simplementeUnPorito/vertical-helicopter-control/docs/img/matlab-gui.png

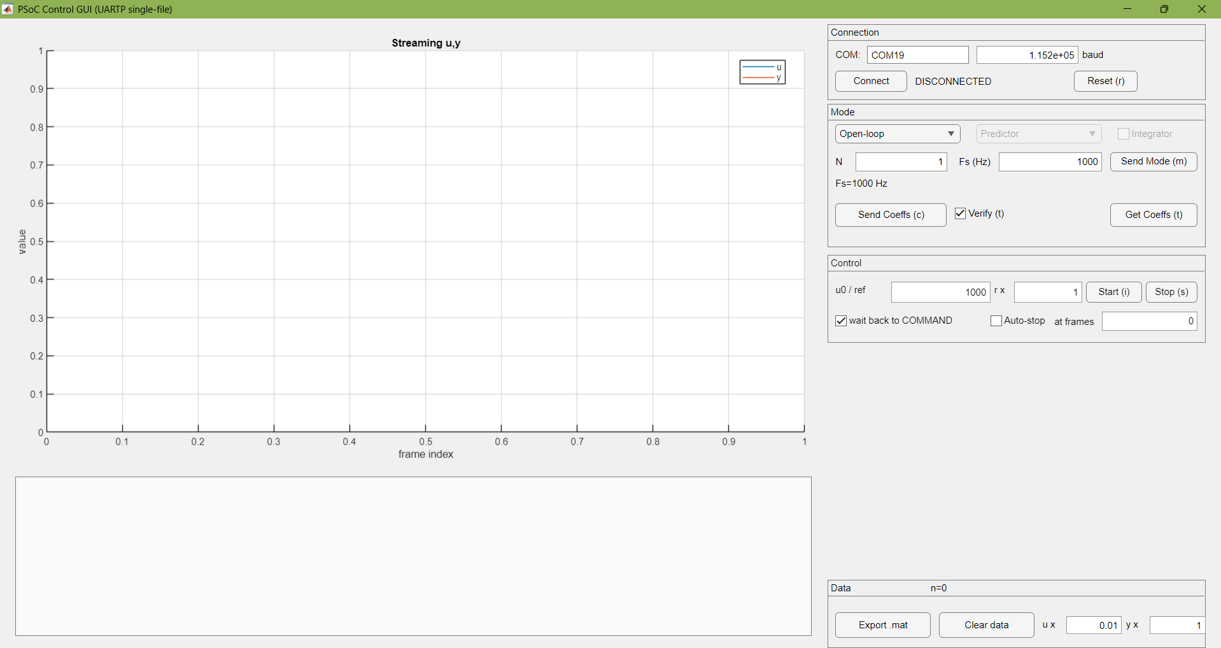
docs/img/matlab-gui.png
