simplementeUnPorito/vertical-helicopter-control/docs/report-src/img/bode/bode_C.png

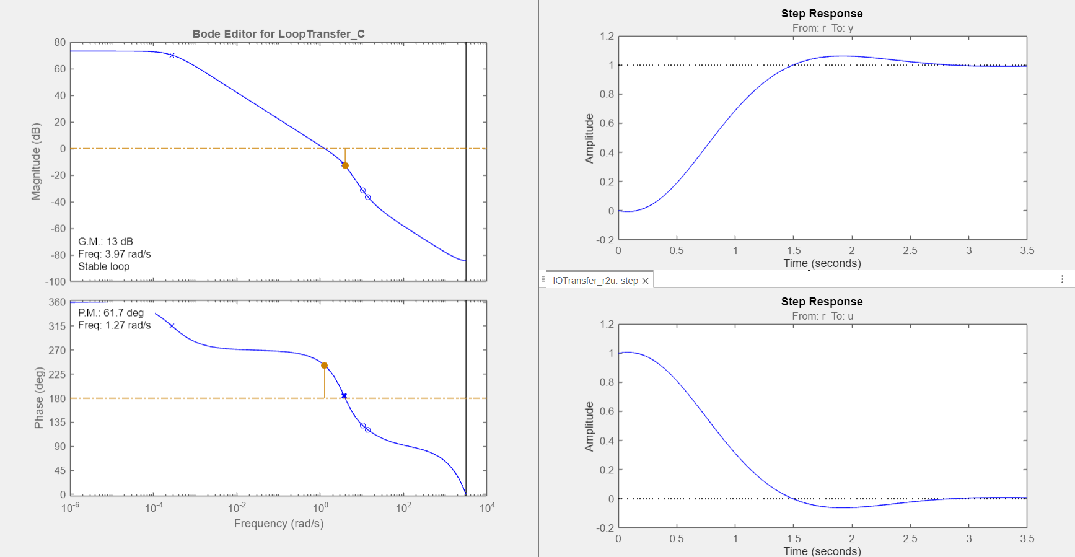
docs/report-src/img/bode/bode_C.png
