simplementeUnPorito/vertical-helicopter-control/docs/report-src/img/bode/bode_compensado.png

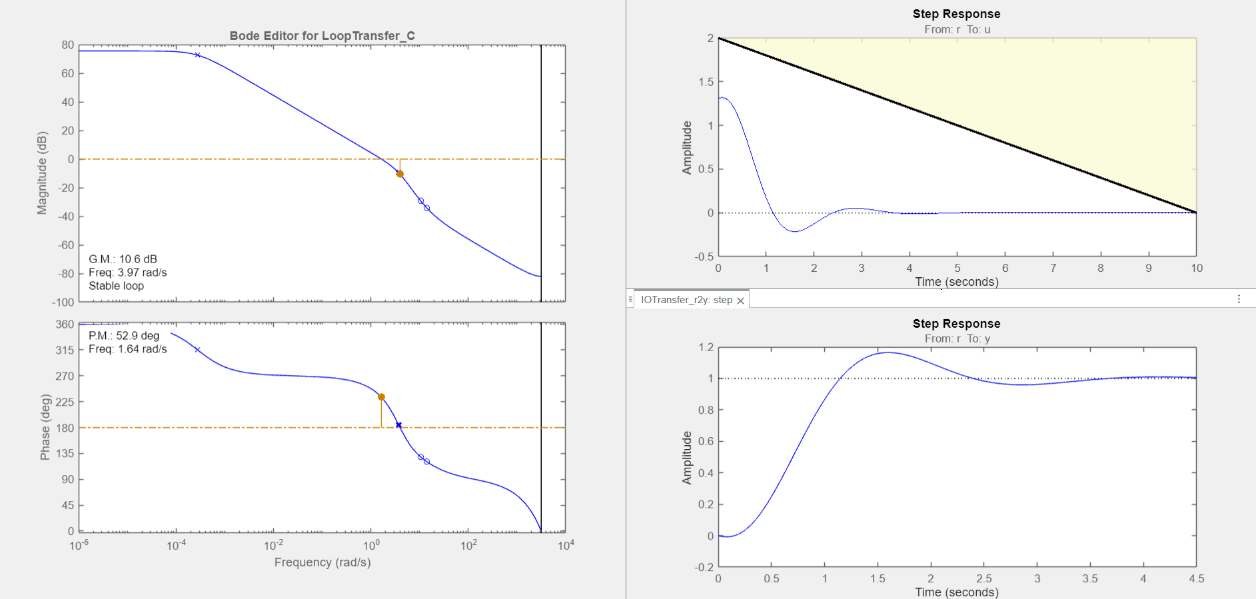
docs/report-src/img/bode/bode_compensado.png
