simplementeUnPorito/vertical-helicopter-control/docs/report-src/img/bode/bode_practica.png

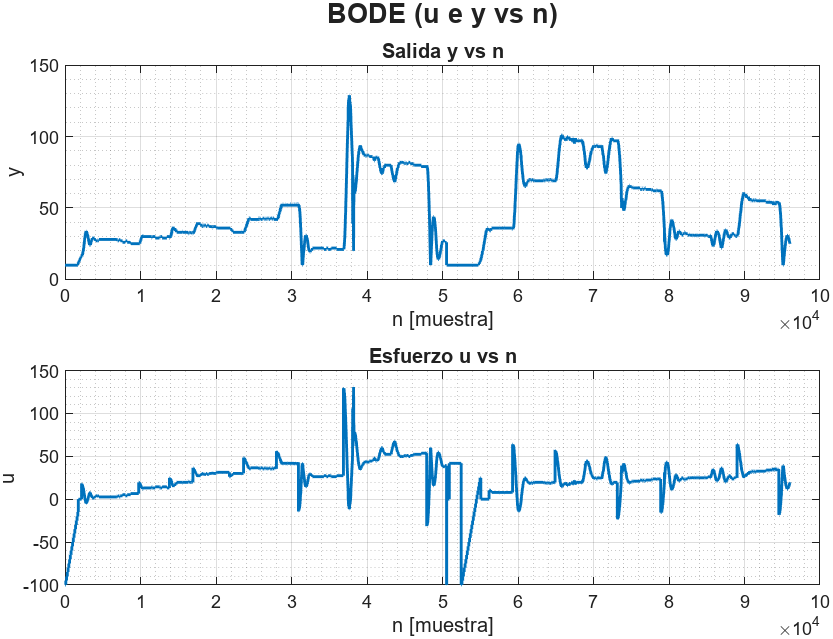
docs/report-src/img/bode/bode_practica.png
