simplementeUnPorito/vertical-helicopter-control/docs/report-src/img/bode/bodeMat.png

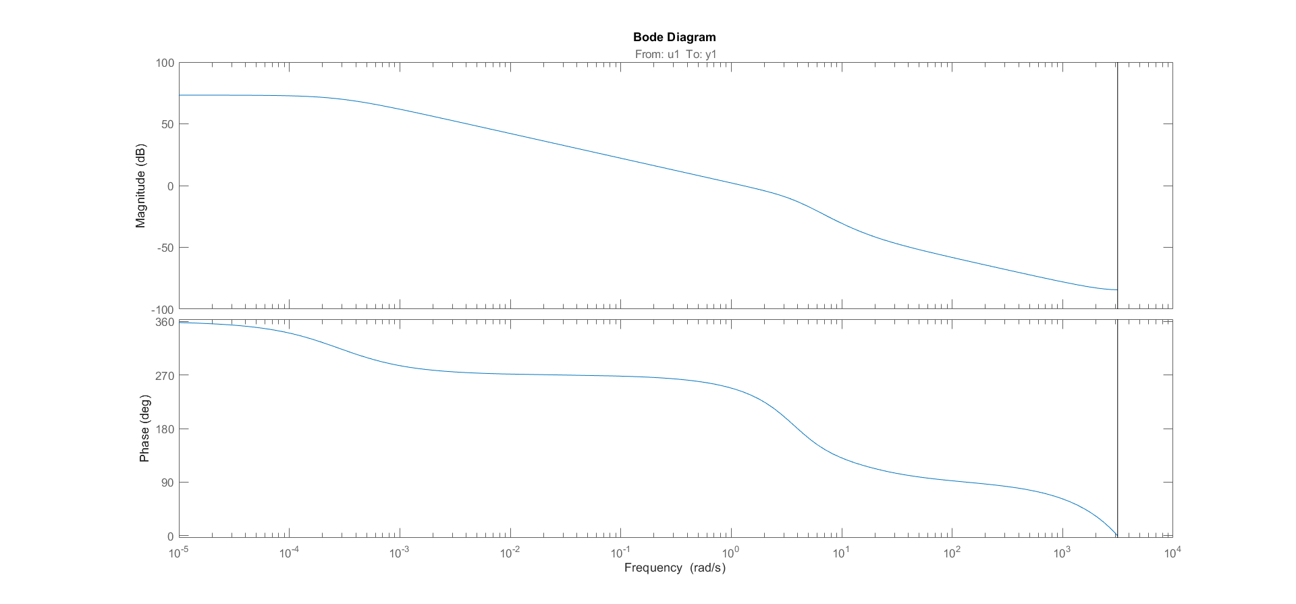
docs/report-src/img/bode/bodeMat.png
