simplementeUnPorito/vertical-helicopter-control/docs/report-src/img/CircUnitarioPlanta.png

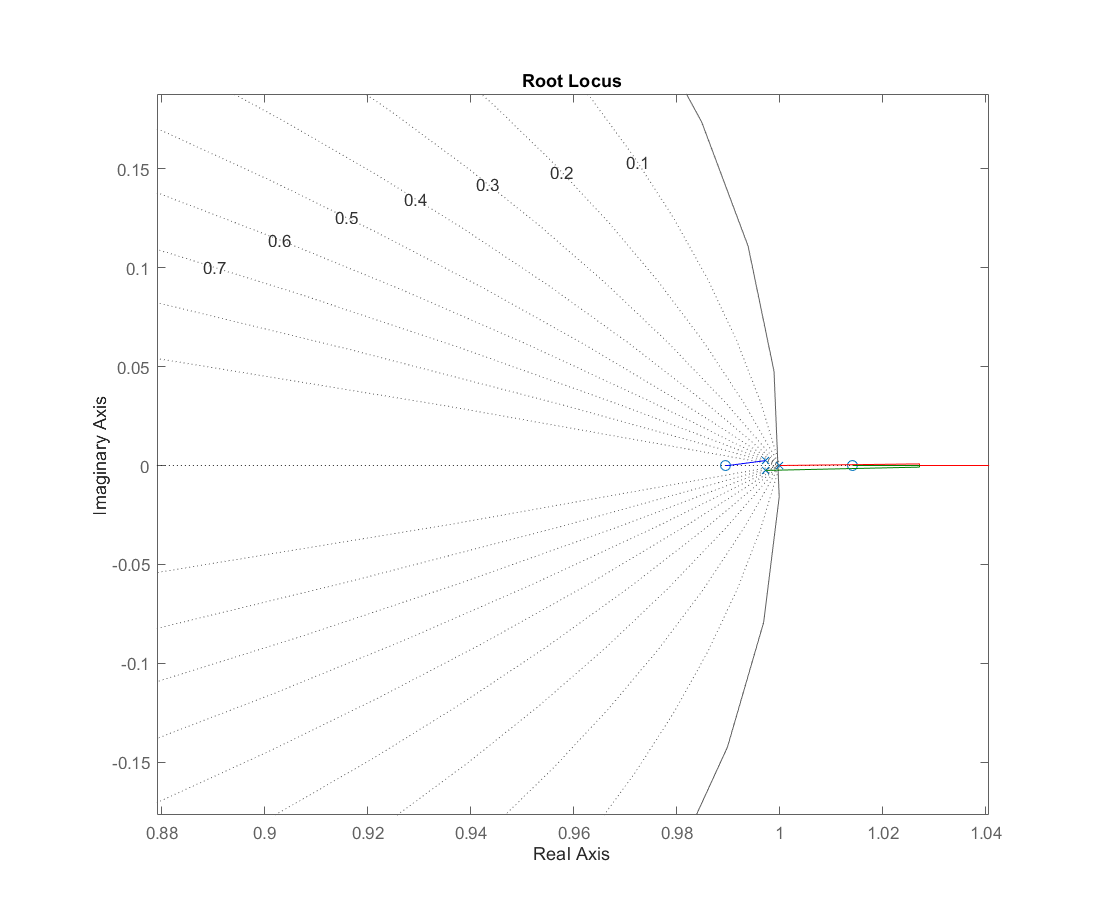
docs/report-src/img/CircUnitarioPlanta.png
