simplementeUnPorito/vertical-helicopter-control/docs/report-src/img/Disenos/abrazadera.png

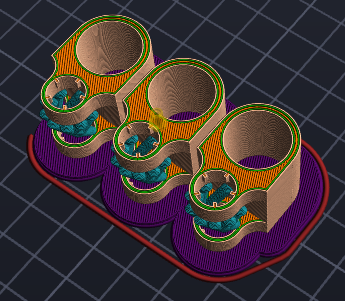
docs/report-src/img/Disenos/abrazadera.png
