simplementeUnPorito/vertical-helicopter-control/docs/report-src/img/Disenos/brazo2.png

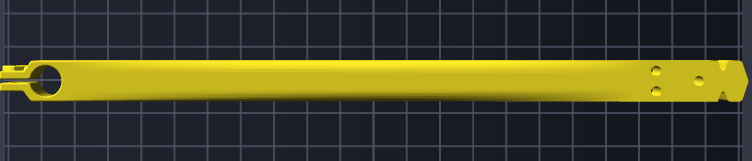
docs/report-src/img/Disenos/brazo2.png
