simplementeUnPorito/vertical-helicopter-control/docs/report-src/img/Disenos/brazo.png

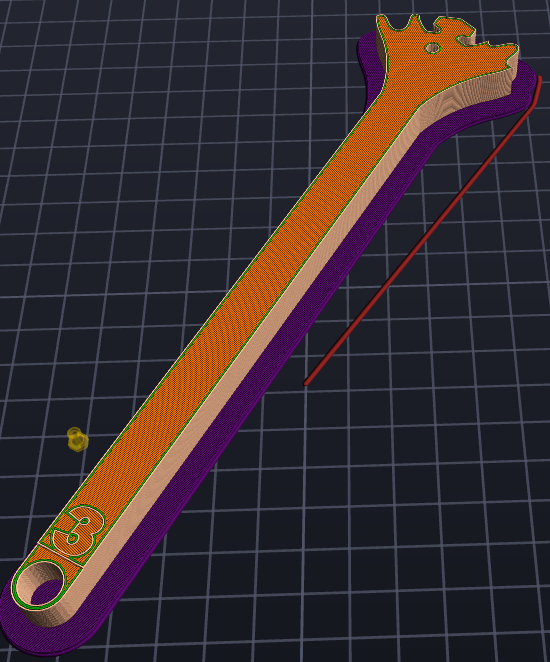
docs/report-src/img/Disenos/brazo.png
