simplementeUnPorito/vertical-helicopter-control/docs/report-src/img/Disenos/cuerpo1.png

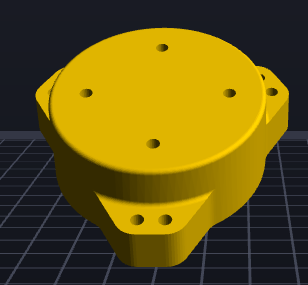
docs/report-src/img/Disenos/cuerpo1.png
