simplementeUnPorito/vertical-helicopter-control/docs/report-src/img/Disenos/cuerpo3.jpeg

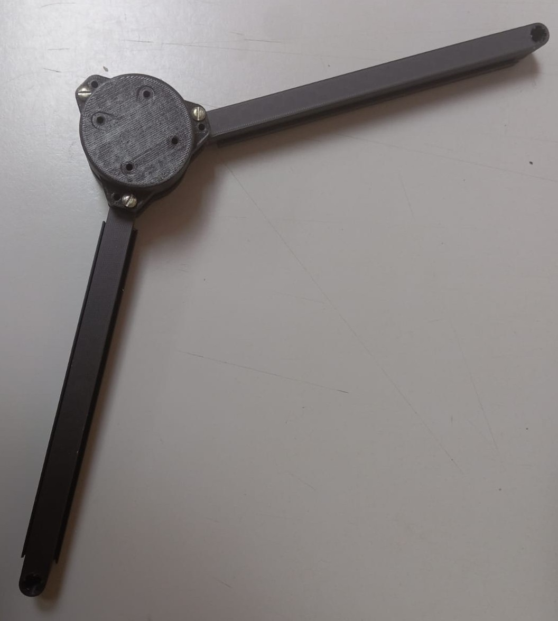
docs/report-src/img/Disenos/cuerpo3.jpeg
