simplementeUnPorito/vertical-helicopter-control/docs/report-src/img/Disenos/cuerpo-soporte3.jpeg

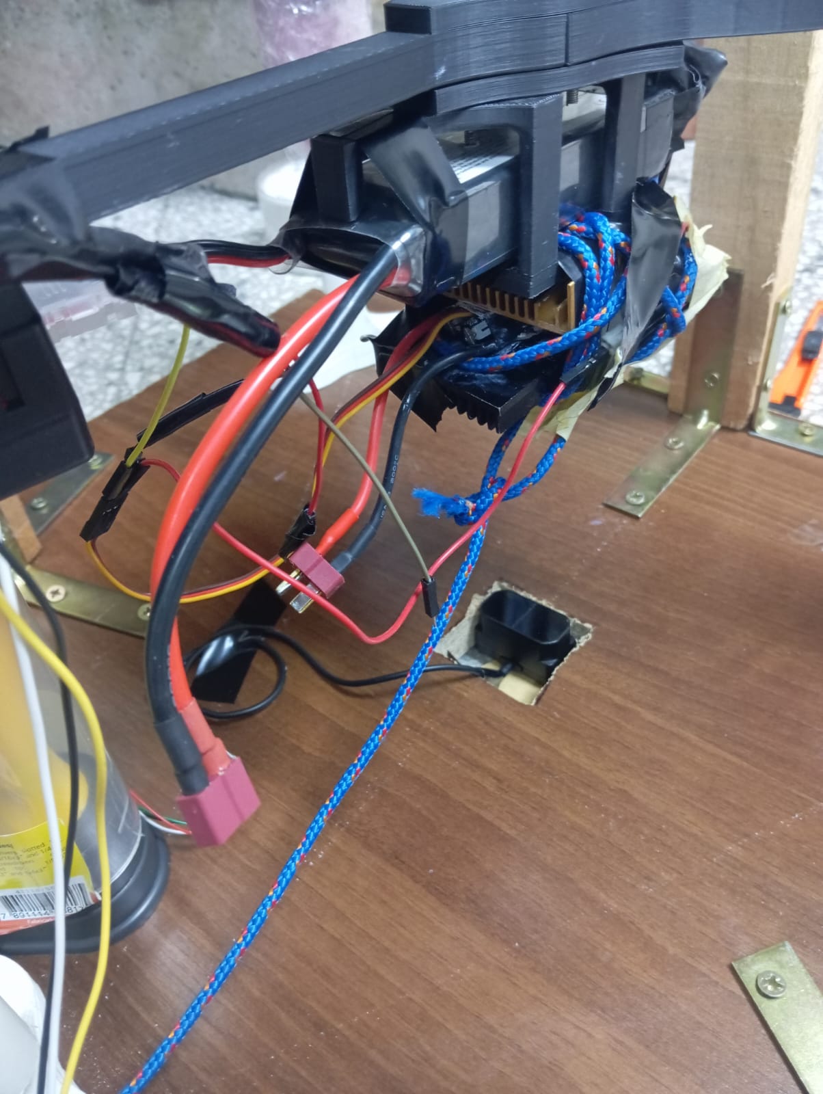
docs/report-src/img/Disenos/cuerpo-soporte3.jpeg
