simplementeUnPorito/vertical-helicopter-control/docs/report-src/img/Disenos/soporte-bateria.jpeg

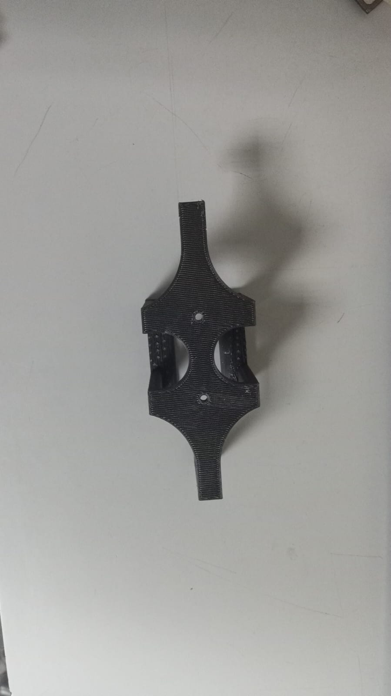
docs/report-src/img/Disenos/soporte-bateria.jpeg
