simplementeUnPorito/vertical-helicopter-control/docs/report-src/img/Disenos/soporte-cuerpo.png

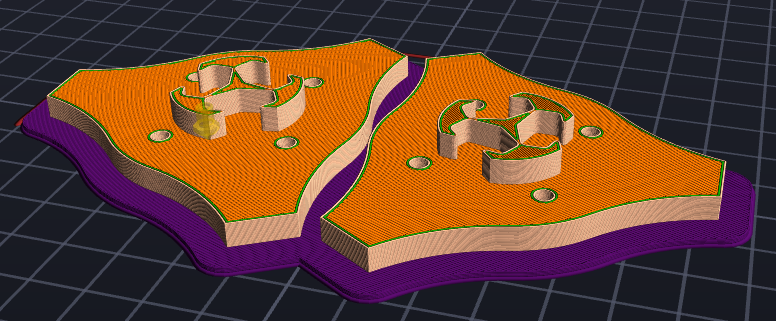
docs/report-src/img/Disenos/soporte-cuerpo.png
