simplementeUnPorito/vertical-helicopter-control/docs/report-src/img/Disenos/soporte_base.png

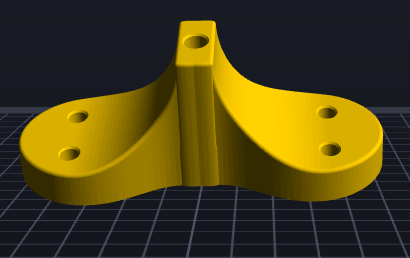
docs/report-src/img/Disenos/soporte_base.png
