simplementeUnPorito/vertical-helicopter-control/docs/report-src/img/Disenos/soporte_techo.png

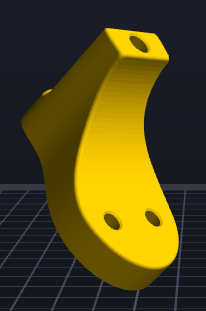
docs/report-src/img/Disenos/soporte_techo.png
