simplementeUnPorito/vertical-helicopter-control/docs/report-src/img/ima/bodePID.png

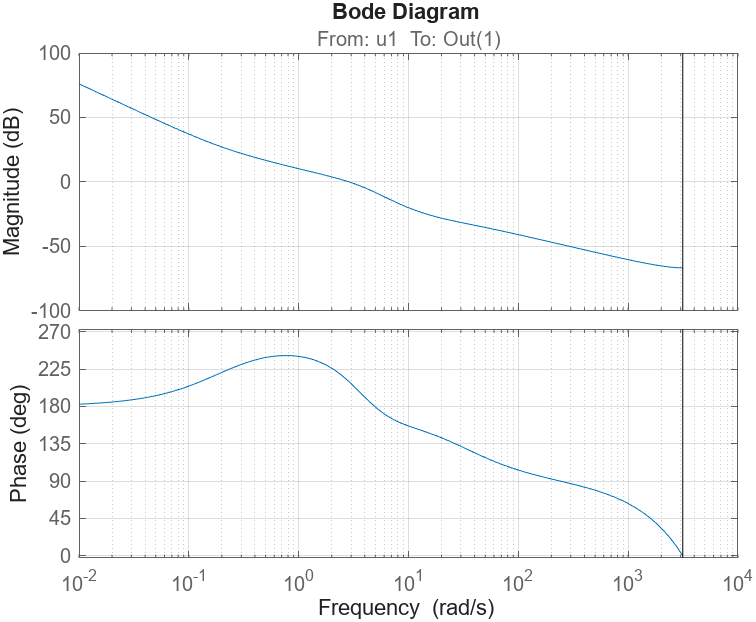
docs/report-src/img/ima/bodePID.png
