simplementeUnPorito/vertical-helicopter-control/docs/report-src/img/ima/circuloUnitarioPID.png

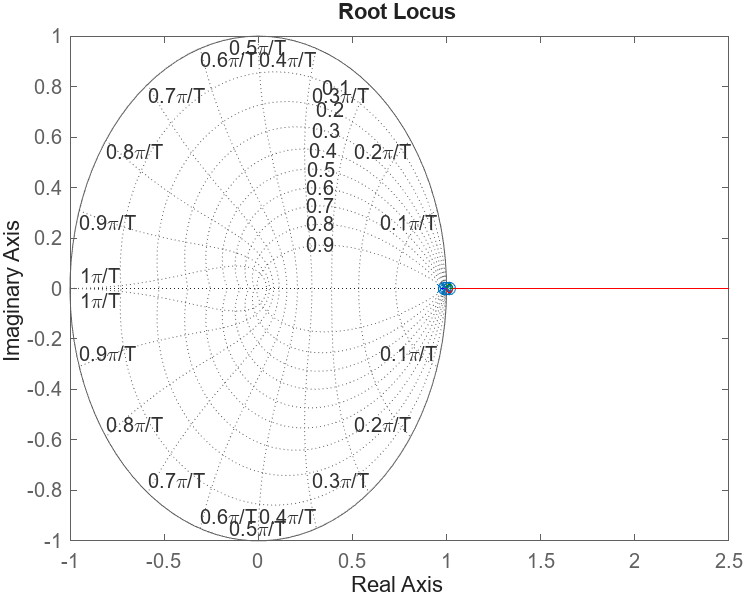
docs/report-src/img/ima/circuloUnitarioPID.png
