simplementeUnPorito/vertical-helicopter-control/docs/report-src/img/ima/rstaPID.png

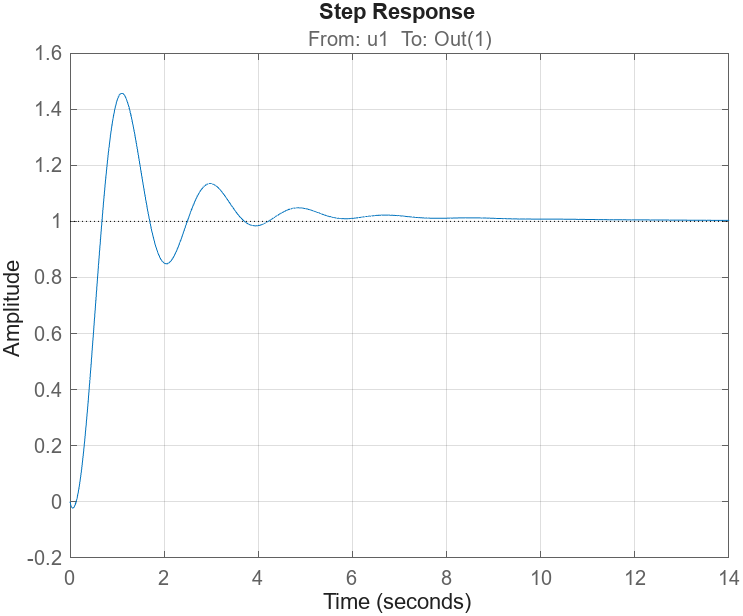
docs/report-src/img/ima/rstaPID.png
