simplementeUnPorito/vertical-helicopter-control/docs/report-src/img/LQGi/LQGi_esfuerzo_ruido.png

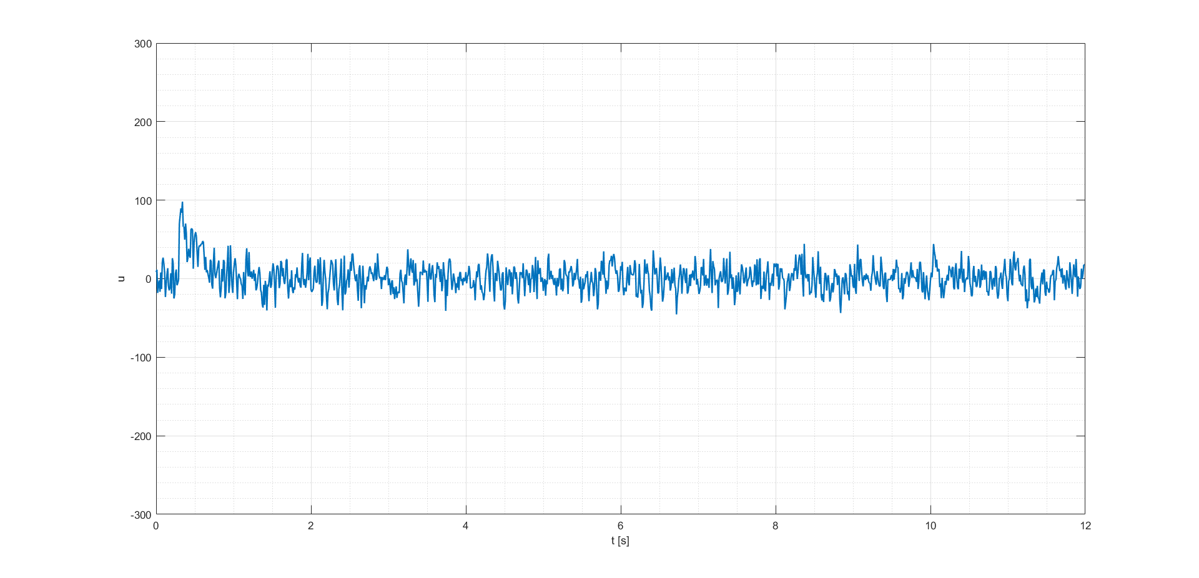
docs/report-src/img/LQGi/LQGi_esfuerzo_ruido.png
