simplementeUnPorito/vertical-helicopter-control/docs/report-src/img/LQGi/LQGi_pzmap_NaranajaOBS_AzulPLANTA.png

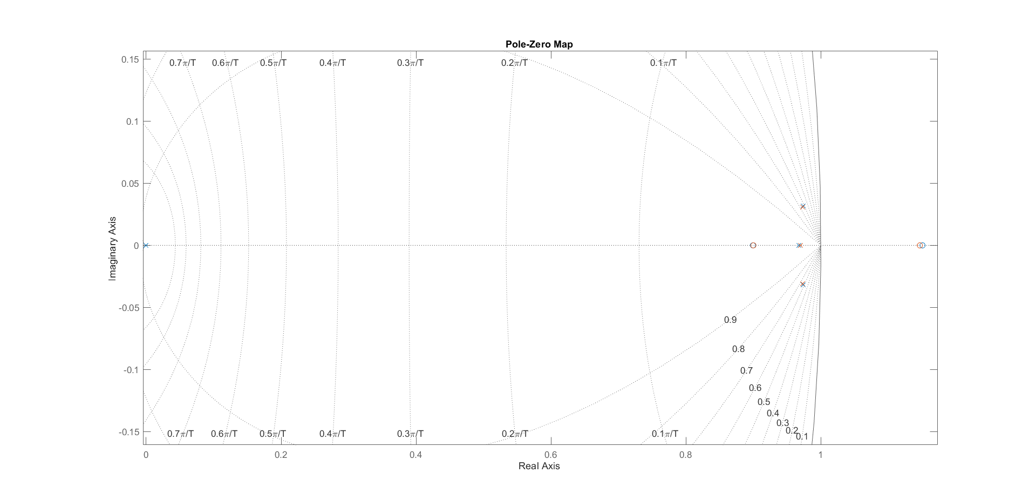
docs/report-src/img/LQGi/LQGi_pzmap_NaranajaOBS_AzulPLANTA.png
