simplementeUnPorito/vertical-helicopter-control/docs/report-src/img/LQR/LQR_esfuerzo.png

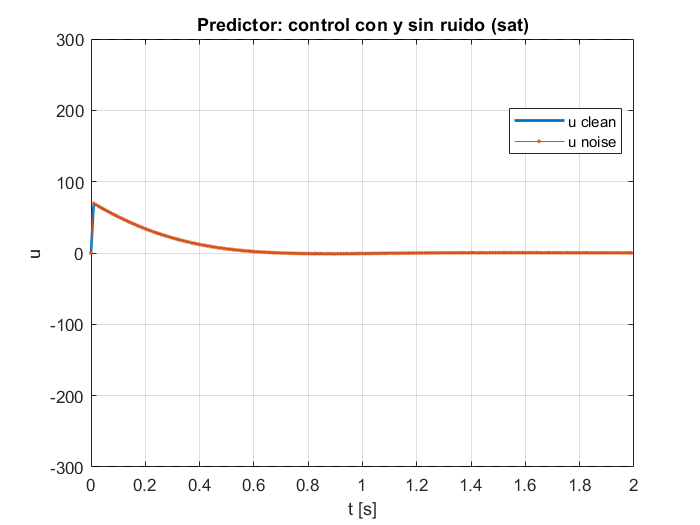
docs/report-src/img/LQR/LQR_esfuerzo.png
