simplementeUnPorito/vertical-helicopter-control/docs/report-src/img/LQR/LQR_pred_practico.png

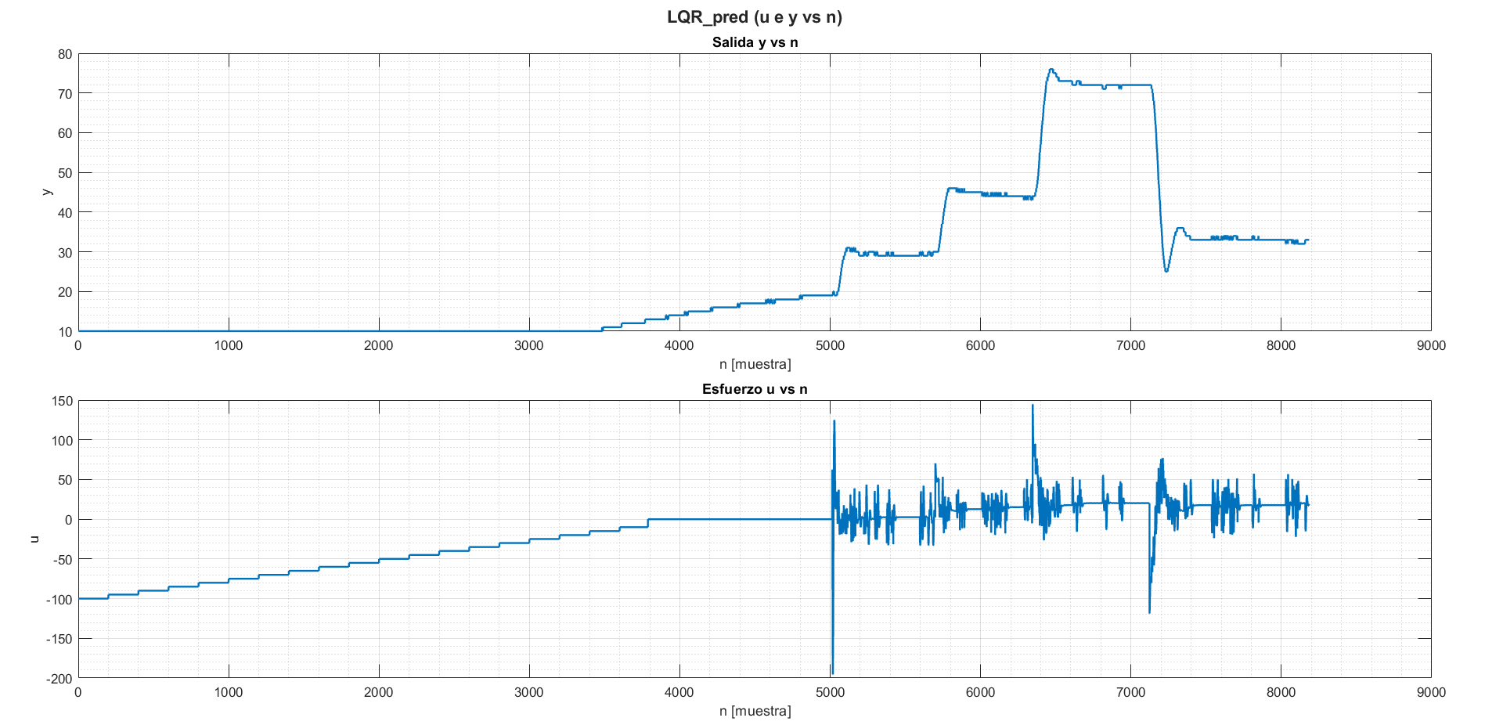
docs/report-src/img/LQR/LQR_pred_practico.png
