simplementeUnPorito/vertical-helicopter-control/docs/report-src/img/PID/Astrom.png

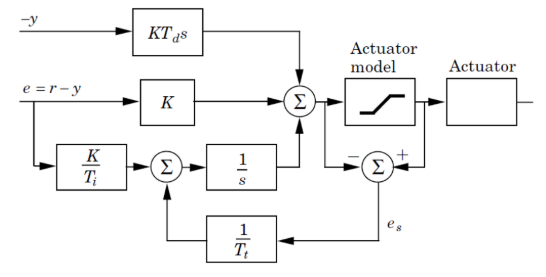
docs/report-src/img/PID/Astrom.png
