simplementeUnPorito/vertical-helicopter-control/docs/report-src/img/PID/astrom_diagrama.png

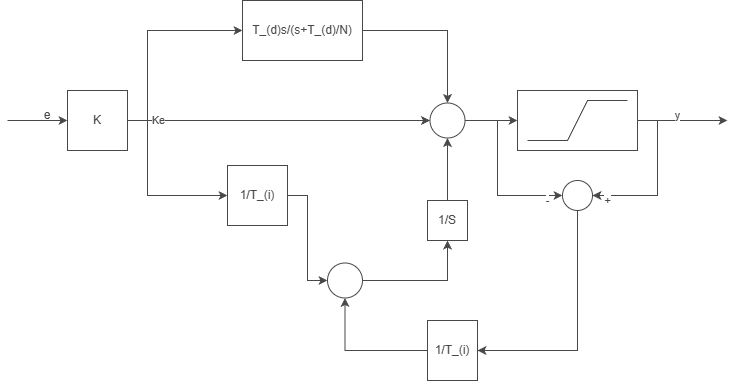
docs/report-src/img/PID/astrom_diagrama.png
