simplementeUnPorito/vertical-helicopter-control/docs/report-src/img/PID/EsfuerzoPID.png

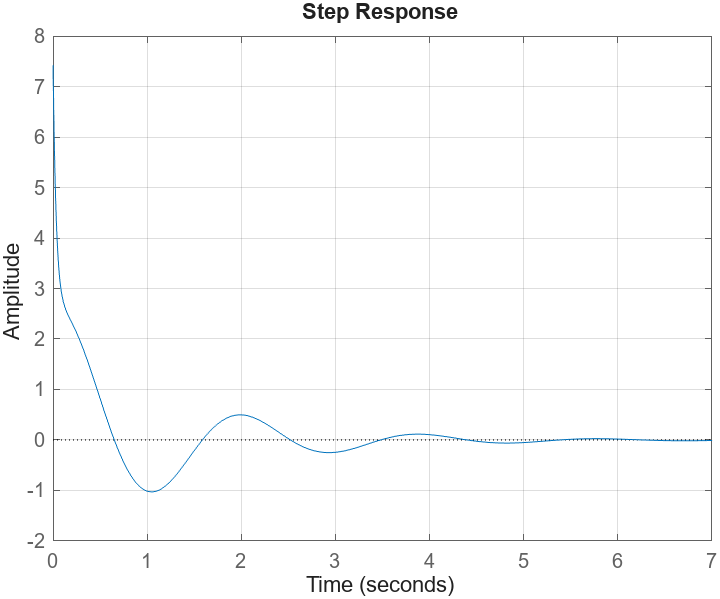
docs/report-src/img/PID/EsfuerzoPID.png
