simplementeUnPorito/vertical-helicopter-control/docs/report-src/img/PID/RstaPID.png

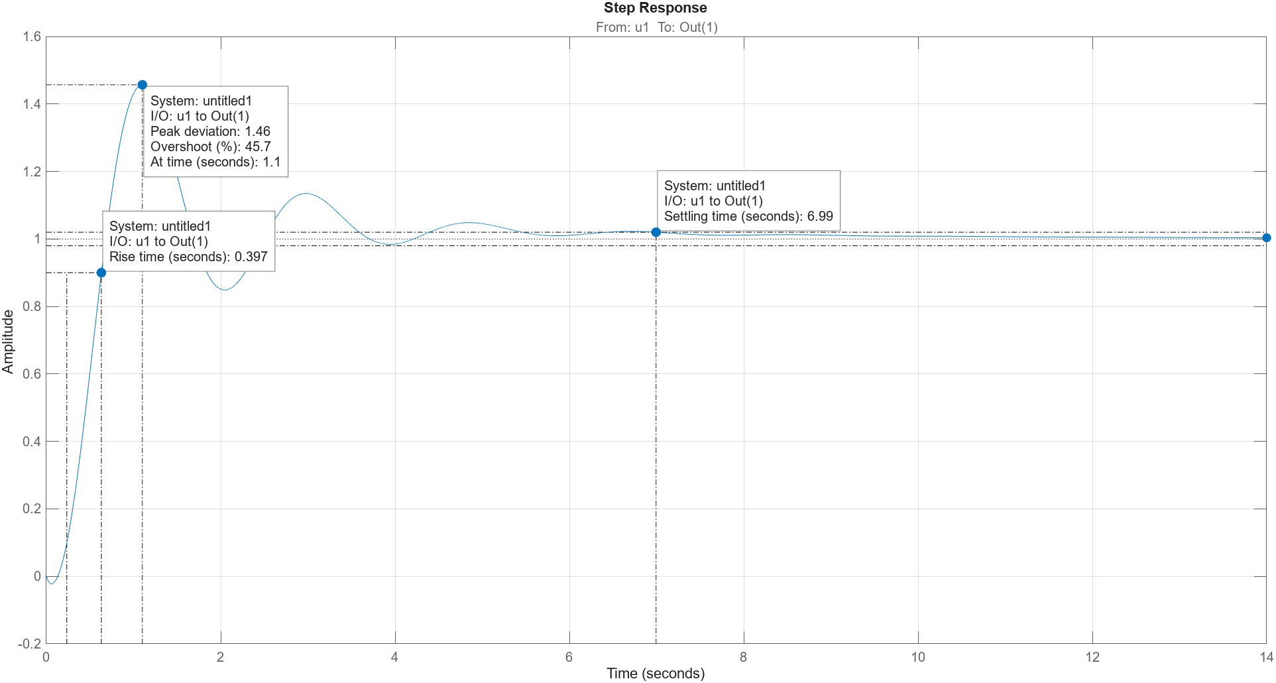
docs/report-src/img/PID/RstaPID.png
