simplementeUnPorito/vertical-helicopter-control/docs/report-src/img/Planta/baseMedida.png

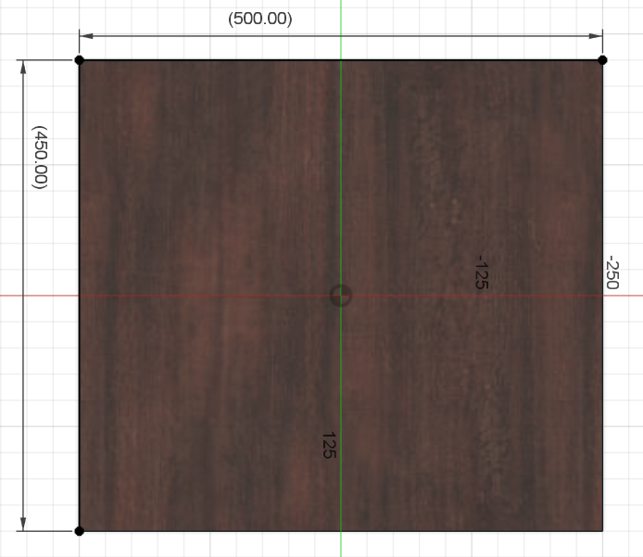
docs/report-src/img/Planta/baseMedida.png
