simplementeUnPorito/vertical-helicopter-control/docs/report-src/img/Planta/bateria2200.jpg

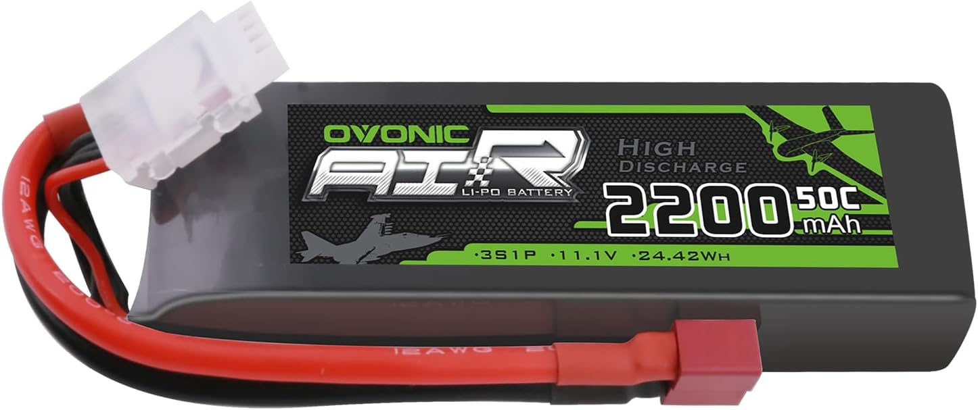
docs/report-src/img/Planta/bateria2200.jpg
