simplementeUnPorito/vertical-helicopter-control/docs/report-src/img/Planta/Bateria.jpeg

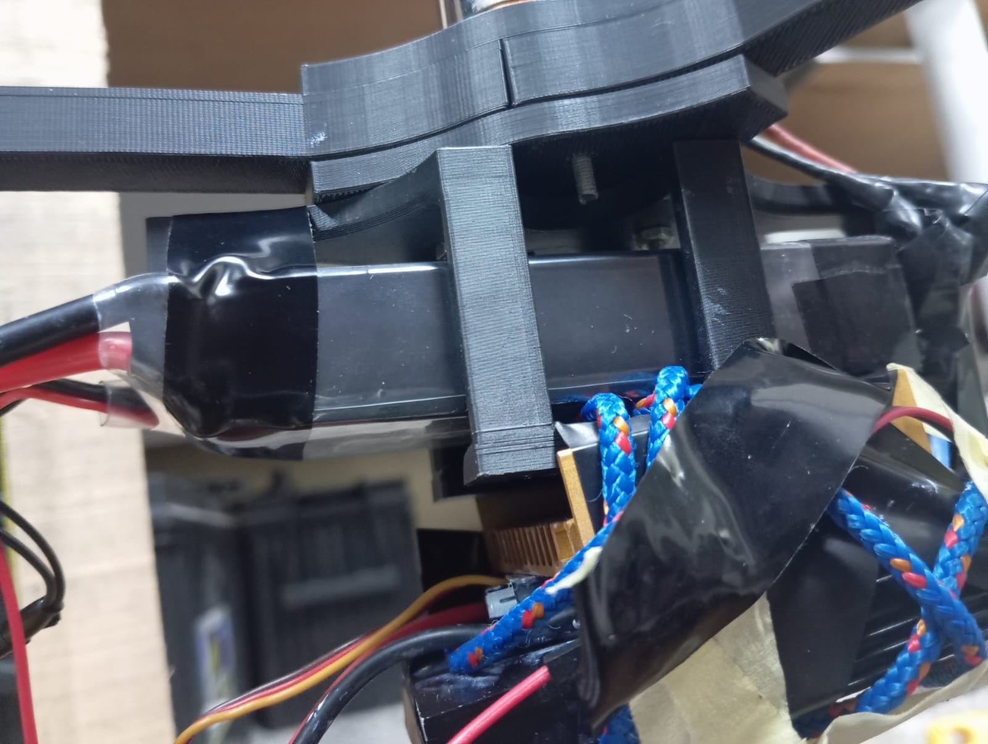
docs/report-src/img/Planta/Bateria.jpeg
