simplementeUnPorito/vertical-helicopter-control/docs/report-src/img/Planta/bateriaAuto.jpeg

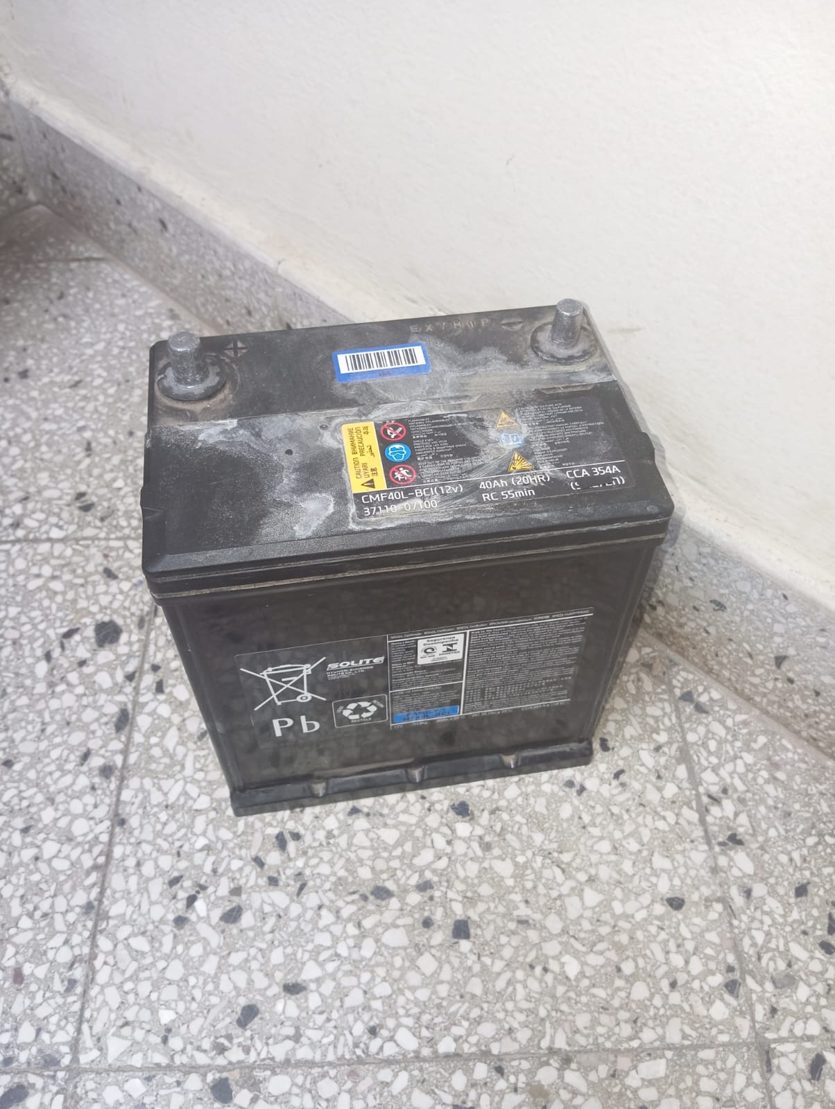
docs/report-src/img/Planta/bateriaAuto.jpeg
