simplementeUnPorito/vertical-helicopter-control/docs/report-src/img/Planta/cintaDeMadera.jpg

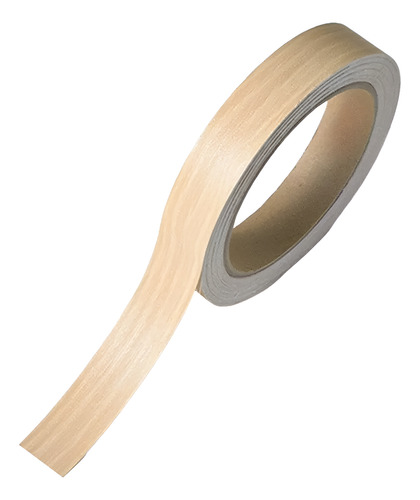
docs/report-src/img/Planta/cintaDeMadera.jpg
