simplementeUnPorito/vertical-helicopter-control/docs/report-src/img/Planta/cintametrica.jpg

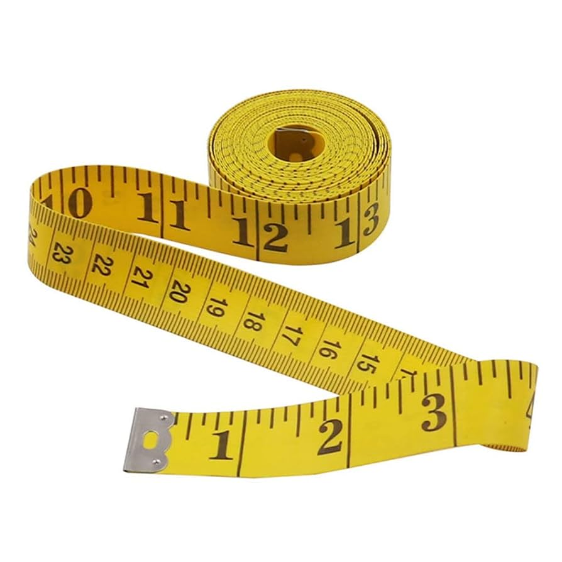
docs/report-src/img/Planta/cintametrica.jpg
