simplementeUnPorito/vertical-helicopter-control/docs/report-src/img/Planta/cuerpoDeDron2.jpeg

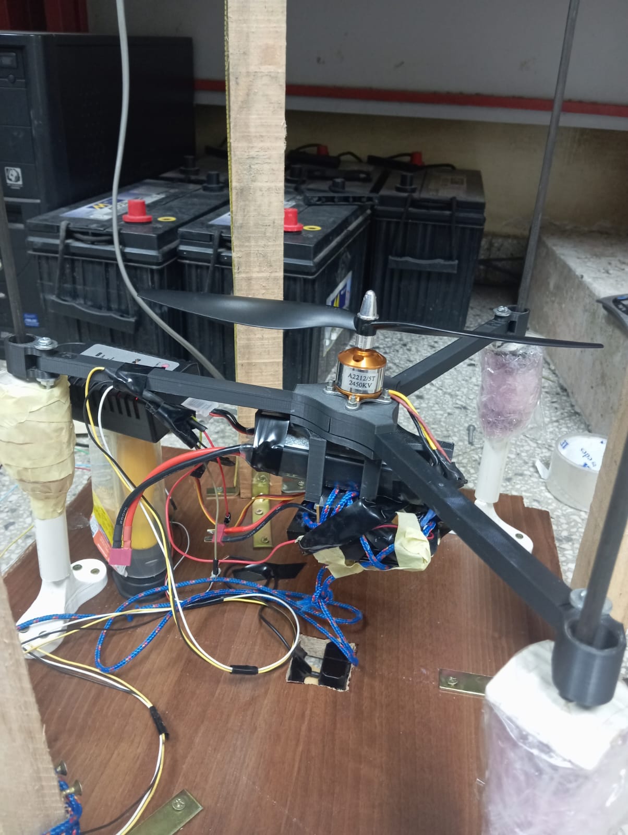
docs/report-src/img/Planta/cuerpoDeDron2.jpeg
