simplementeUnPorito/vertical-helicopter-control/docs/report-src/img/Planta/Diagrama-Page-2.jpg

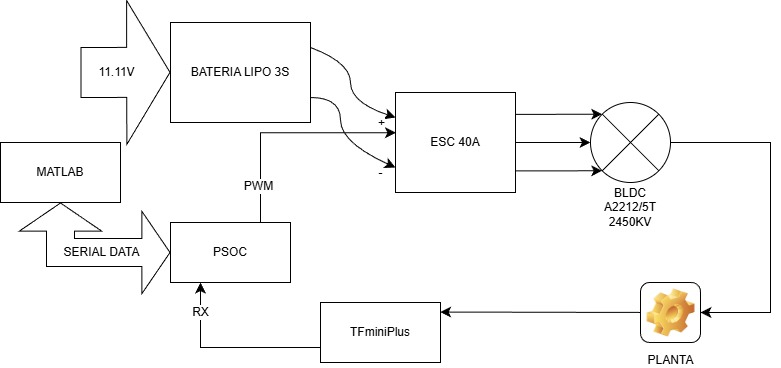
docs/report-src/img/Planta/Diagrama-Page-2.jpg
