simplementeUnPorito/vertical-helicopter-control/docs/report-src/img/Planta/Diagrama.jpg

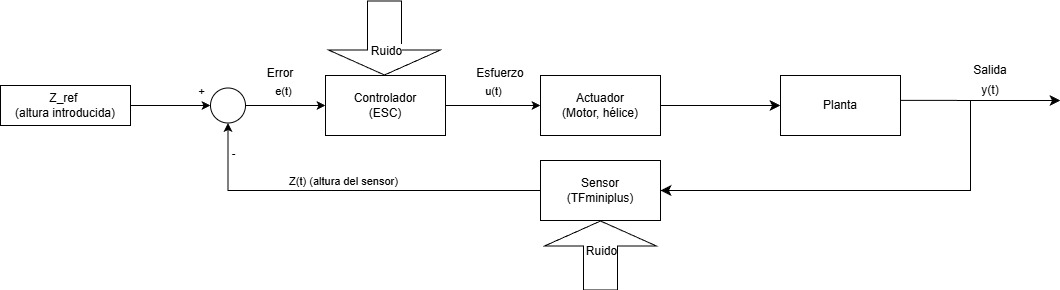
docs/report-src/img/Planta/Diagrama.jpg
