simplementeUnPorito/vertical-helicopter-control/docs/report-src/img/Planta/Dron_Desde_arriba.jpeg

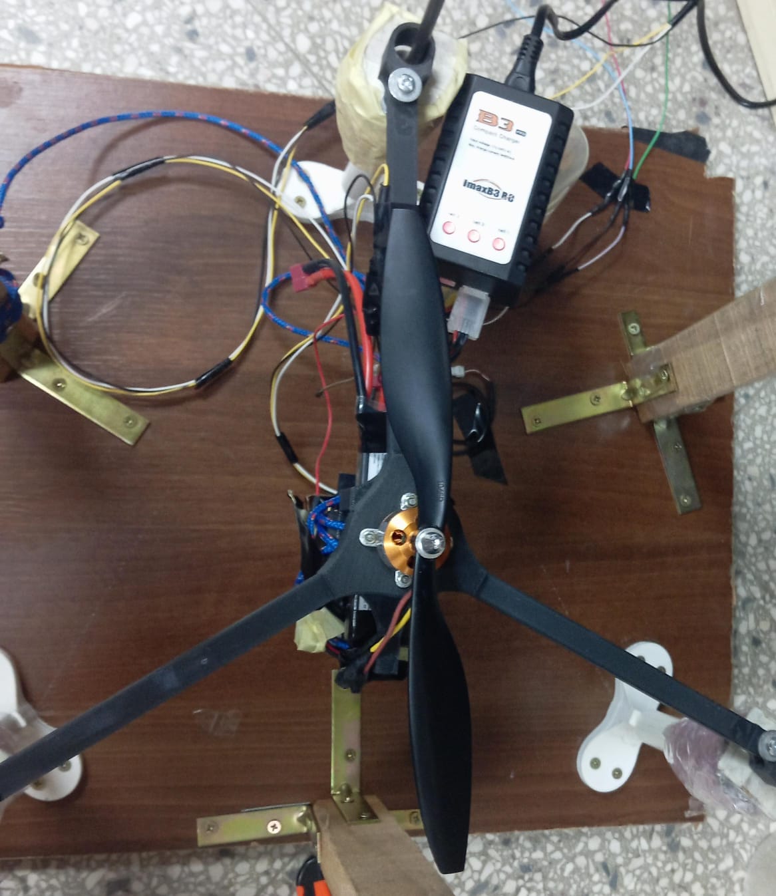
docs/report-src/img/Planta/Dron_Desde_arriba.jpeg
