simplementeUnPorito/vertical-helicopter-control/docs/report-src/img/Planta/ESC30A1.jpeg

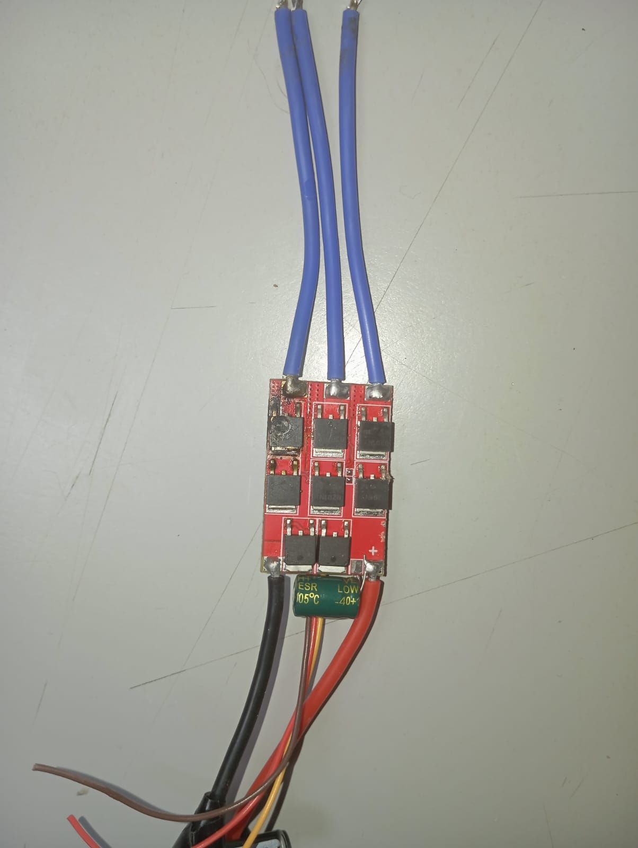
docs/report-src/img/Planta/ESC30A1.jpeg
