simplementeUnPorito/vertical-helicopter-control/docs/report-src/img/Planta/ESC30A2.jpeg

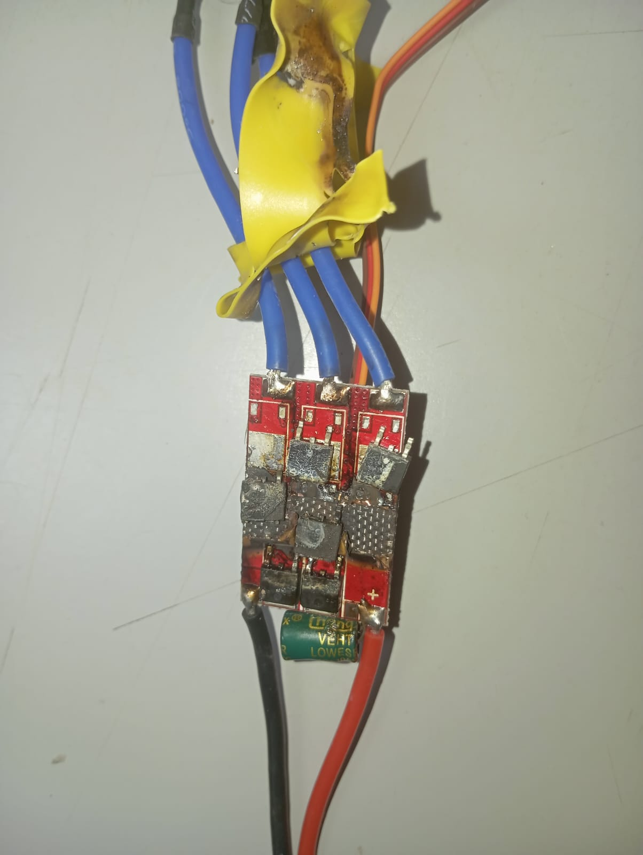
docs/report-src/img/Planta/ESC30A2.jpeg
