simplementeUnPorito/vertical-helicopter-control/docs/report-src/img/Planta/ESC30A3.jpeg

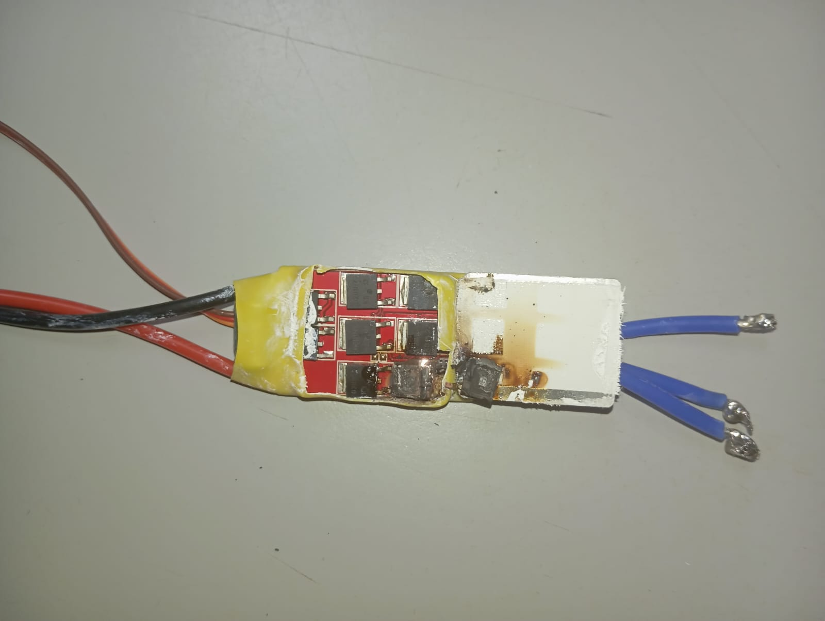
docs/report-src/img/Planta/ESC30A3.jpeg
