simplementeUnPorito/vertical-helicopter-control/docs/report-src/img/Planta/ESC-40A.jpg

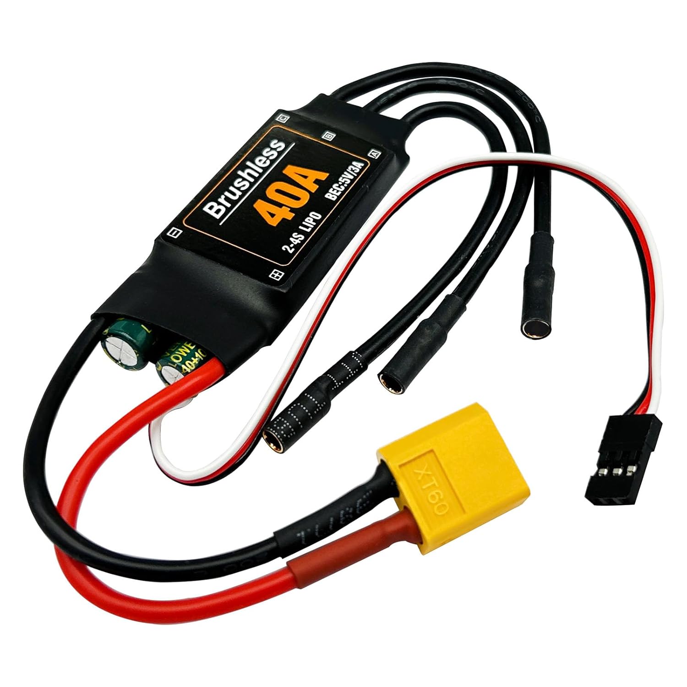
docs/report-src/img/Planta/ESC-40A.jpg
