simplementeUnPorito/vertical-helicopter-control/docs/report-src/img/Planta/helice.jpeg

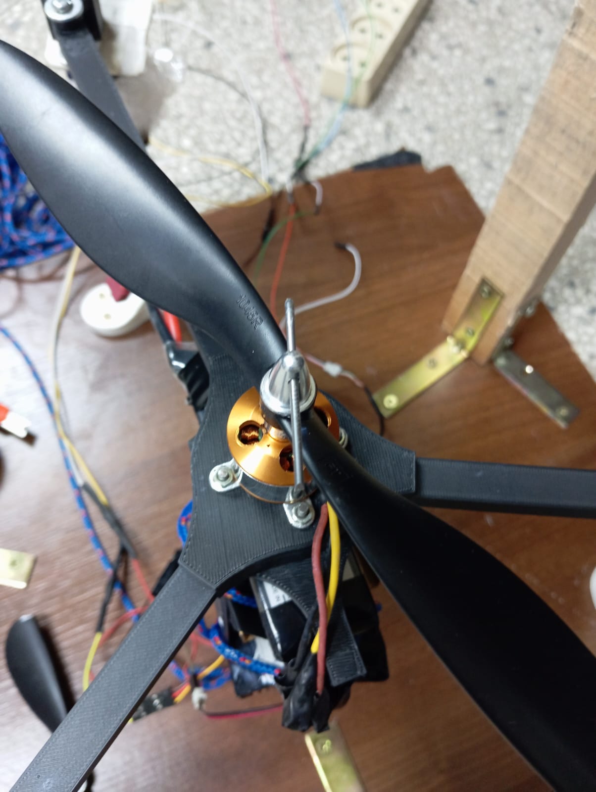
docs/report-src/img/Planta/helice.jpeg
