simplementeUnPorito/vertical-helicopter-control/docs/report-src/img/Planta/heliceMedida.jpeg

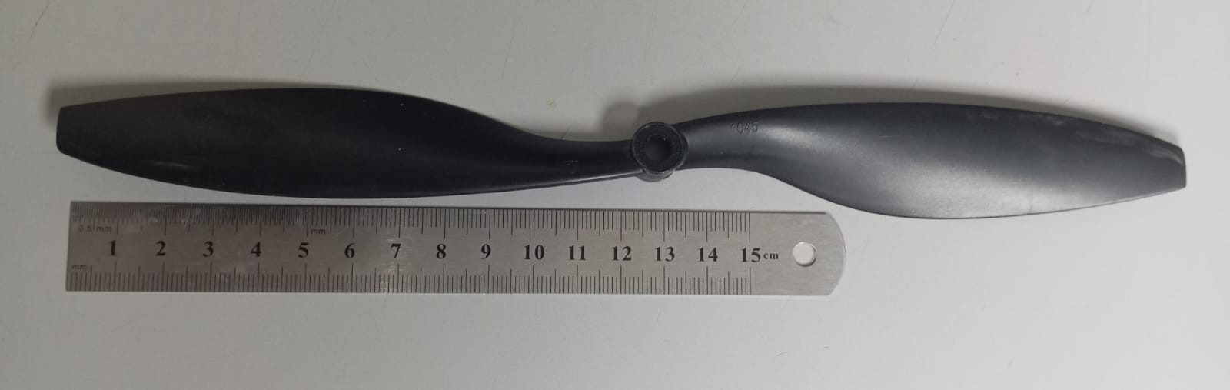
docs/report-src/img/Planta/heliceMedida.jpeg
