simplementeUnPorito/vertical-helicopter-control/docs/report-src/img/Planta/madera.jpg

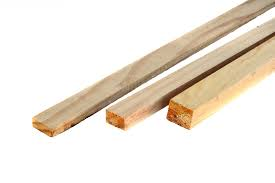
docs/report-src/img/Planta/madera.jpg
