simplementeUnPorito/vertical-helicopter-control/docs/report-src/img/Planta/motor2212.png

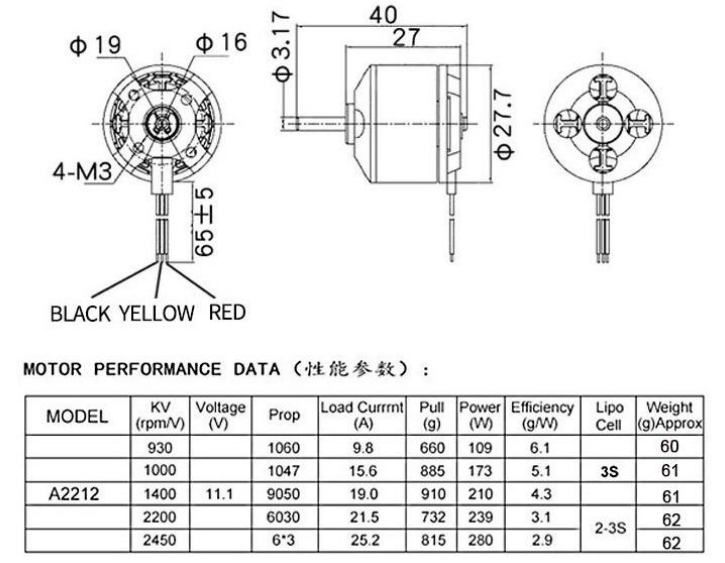
docs/report-src/img/Planta/motor2212.png
