simplementeUnPorito/vertical-helicopter-control/docs/report-src/img/Planta/motor-a2212-2450kv.jpg

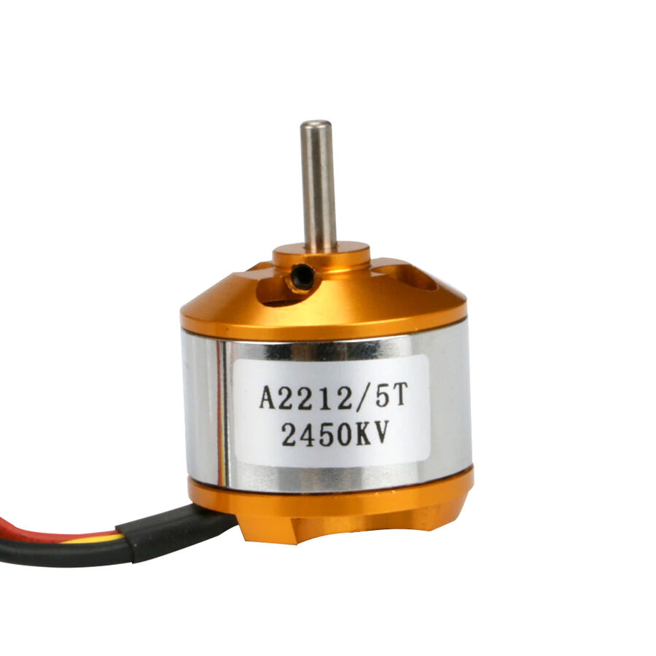
docs/report-src/img/Planta/motor-a2212-2450kv.jpg
