simplementeUnPorito/vertical-helicopter-control/docs/report-src/img/Planta/Motor.jpeg

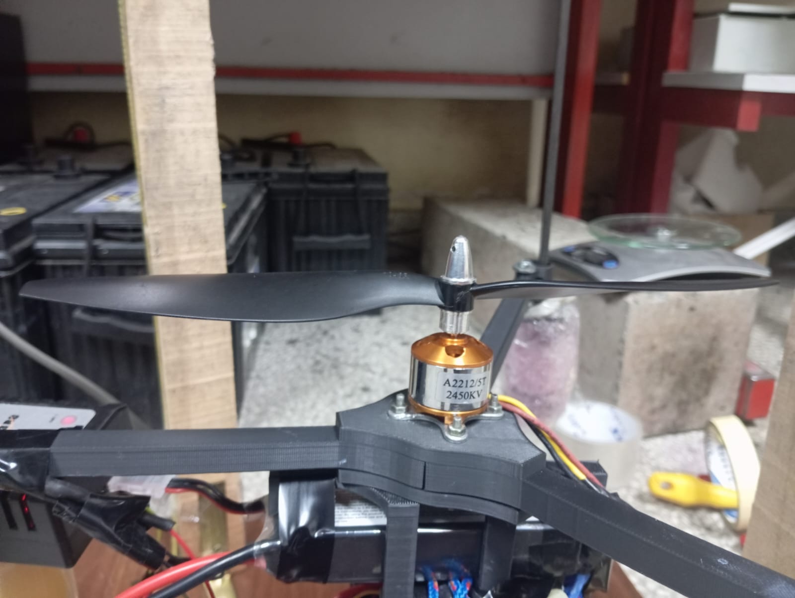
docs/report-src/img/Planta/Motor.jpeg
