simplementeUnPorito/vertical-helicopter-control/docs/report-src/img/Planta/PlantaEntera.jpeg

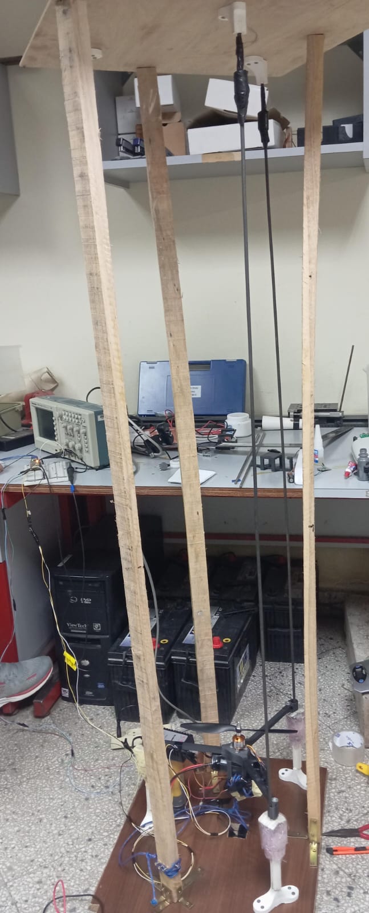
docs/report-src/img/Planta/PlantaEntera.jpeg
