simplementeUnPorito/vertical-helicopter-control/docs/report-src/img/Planta/practicaConLadrillo2.jpeg

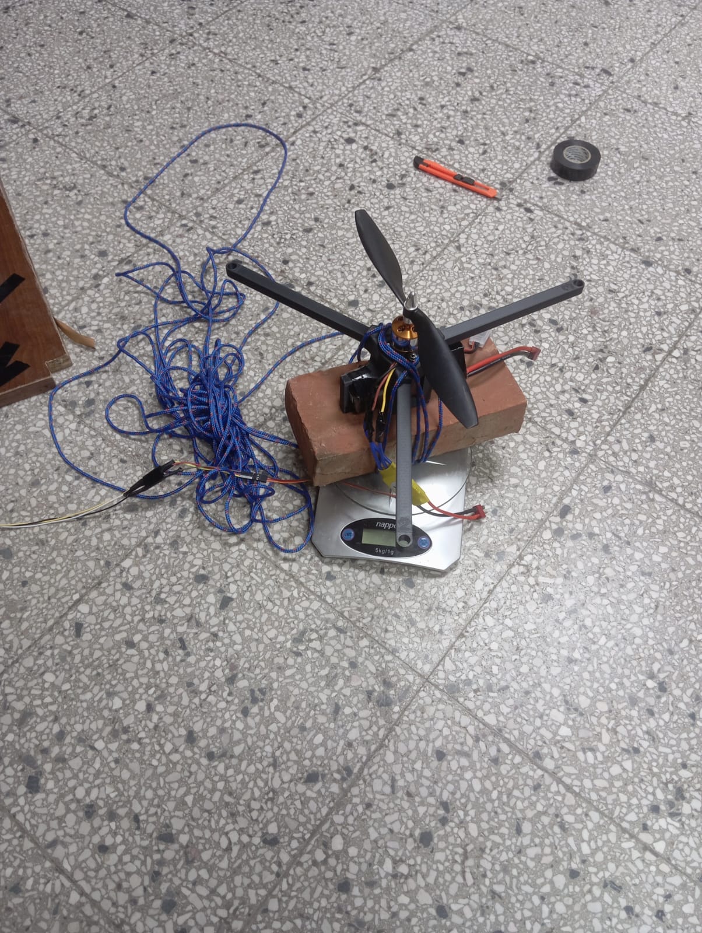
docs/report-src/img/Planta/practicaConLadrillo2.jpeg
