simplementeUnPorito/vertical-helicopter-control/docs/report-src/img/Planta/practicaConLadrillo.jpeg

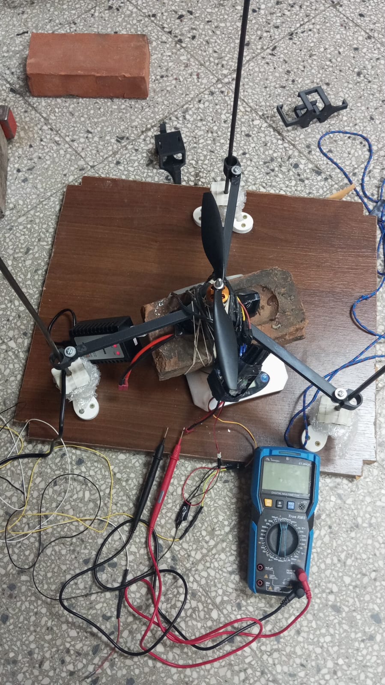
docs/report-src/img/Planta/practicaConLadrillo.jpeg
