simplementeUnPorito/vertical-helicopter-control/docs/report-src/img/Planta/Psoc.jpeg

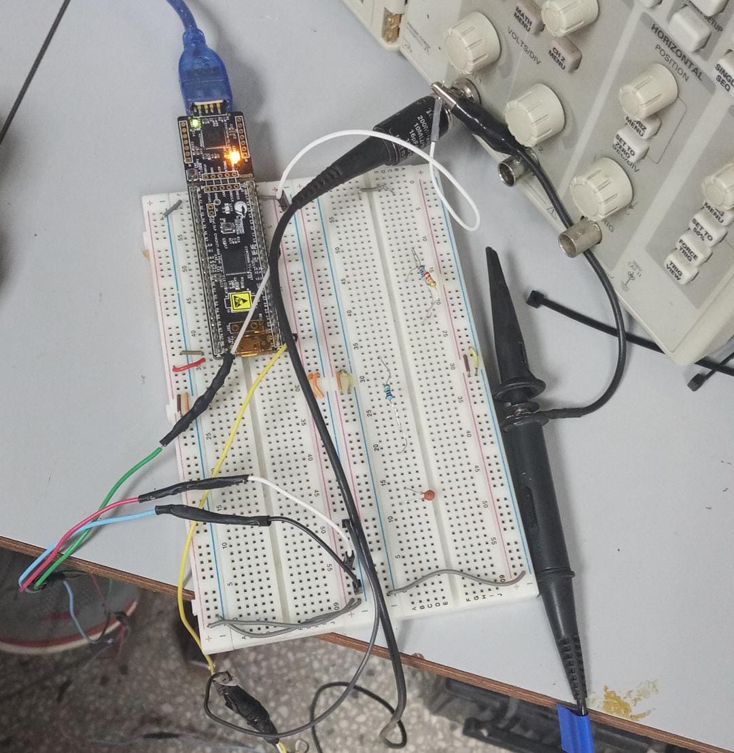
docs/report-src/img/Planta/Psoc.jpeg
