simplementeUnPorito/vertical-helicopter-control/docs/report-src/img/Planta/Sensor.jpeg

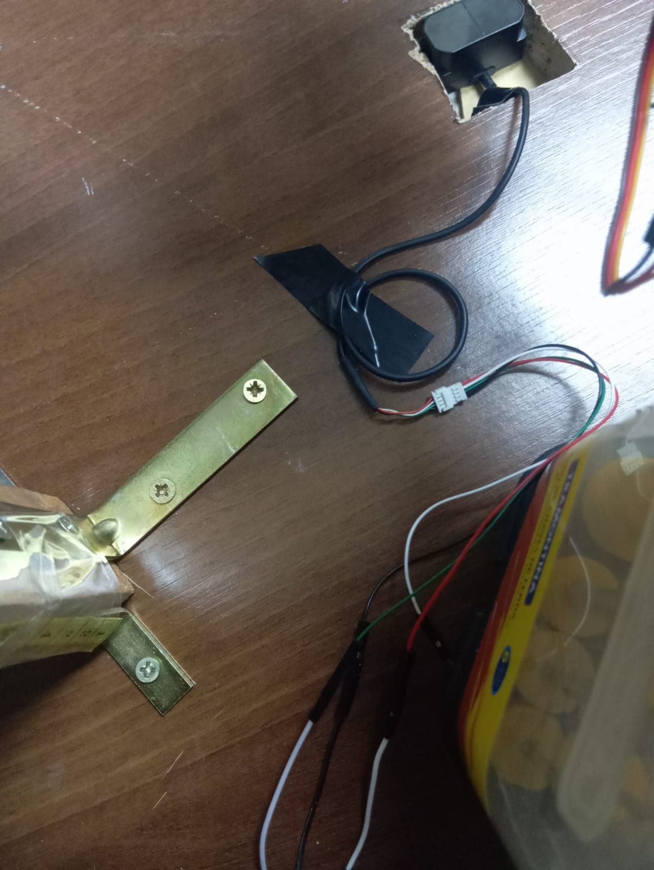
docs/report-src/img/Planta/Sensor.jpeg
