simplementeUnPorito/vertical-helicopter-control/docs/report-src/img/Planta/TechoMedida.png

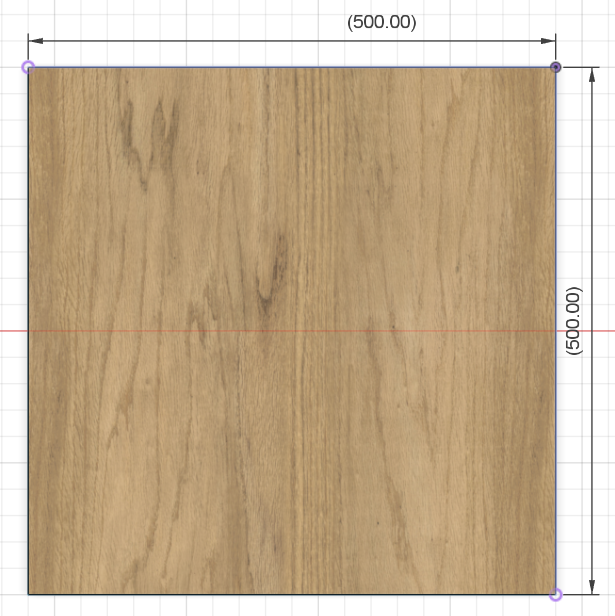
docs/report-src/img/Planta/TechoMedida.png
