simplementeUnPorito/vertical-helicopter-control/docs/report-src/img/Planta/TFminiPlus.png

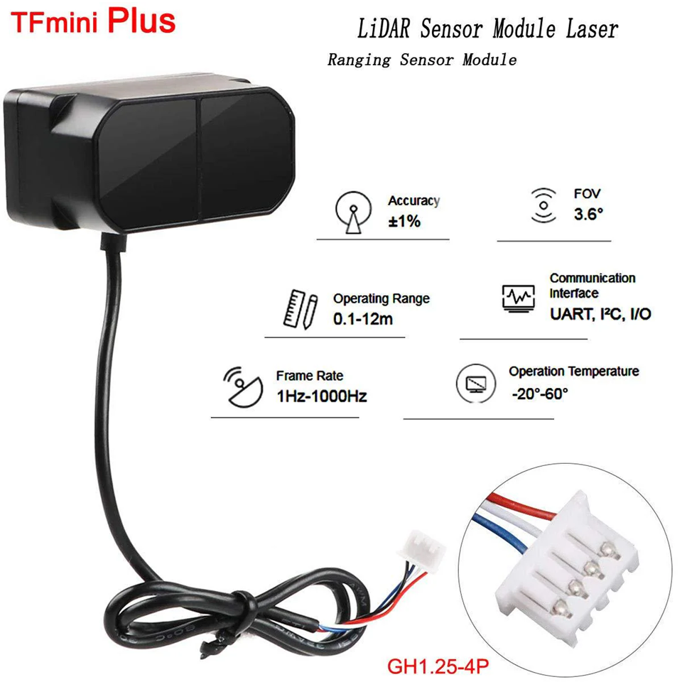
docs/report-src/img/Planta/TFminiPlus.png
