simplementeUnPorito/vertical-helicopter-control/docs/report-src/img/Planta/tornillo.jpg

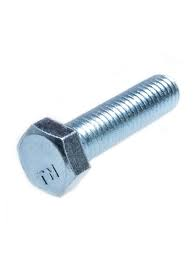
docs/report-src/img/Planta/tornillo.jpg
