simplementeUnPorito/vertical-helicopter-control/docs/report-src/img/Planta/tuboPVC.jpg

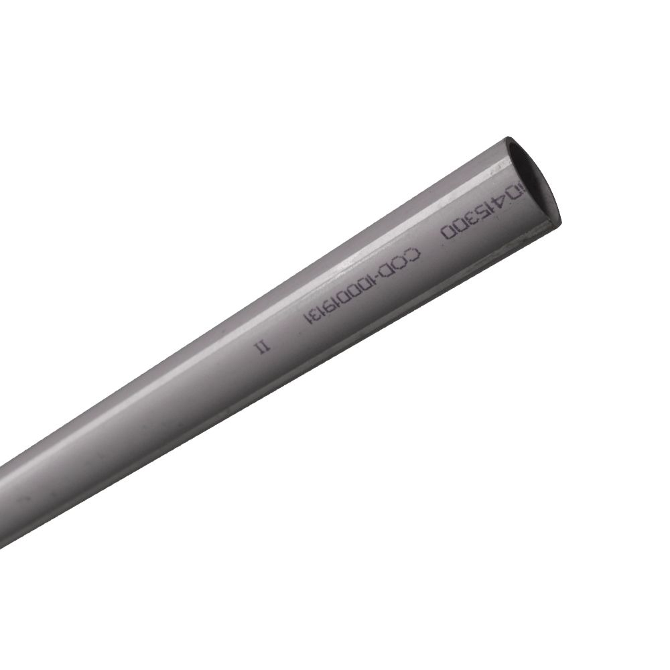
docs/report-src/img/Planta/tuboPVC.jpg
