simplementeUnPorito/vertical-helicopter-control/docs/report-src/img/Planta/Varillas.jpg

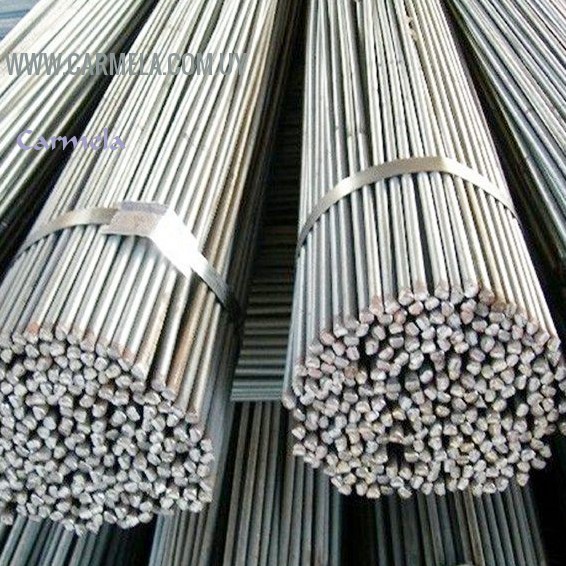
docs/report-src/img/Planta/Varillas.jpg
