simplementeUnPorito/vertical-helicopter-control/docs/report-src/img/Rlocus/Bode1.png

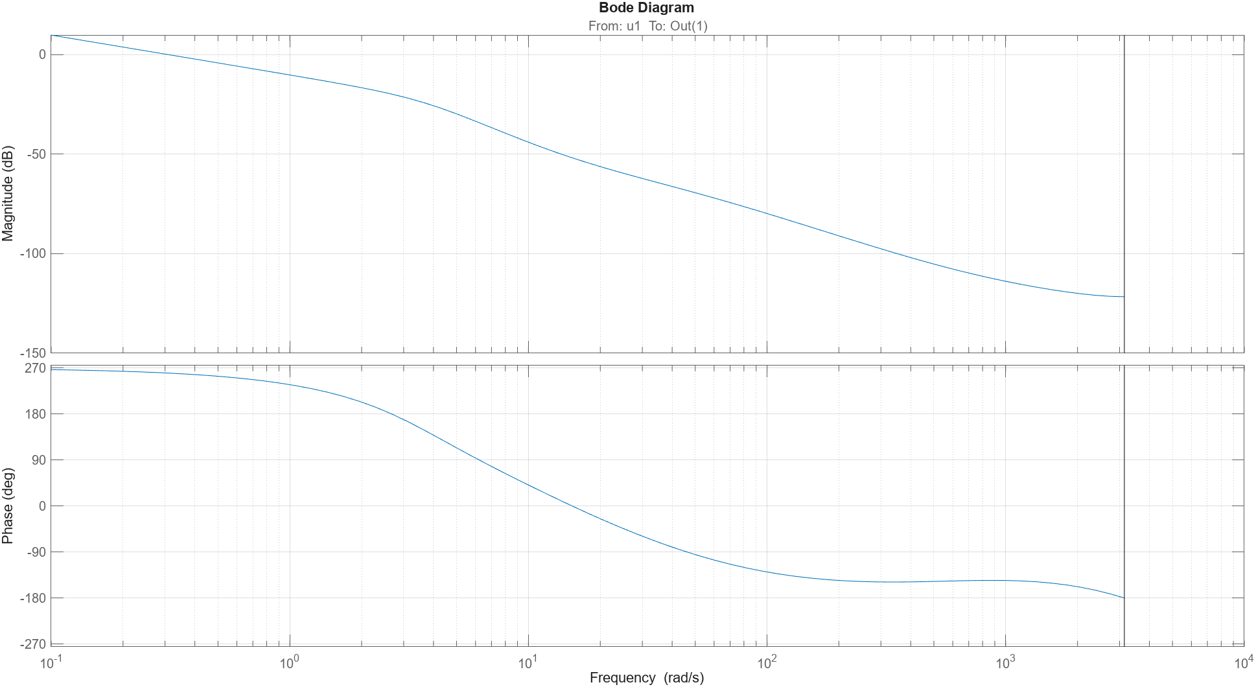
docs/report-src/img/Rlocus/Bode1.png
