simplementeUnPorito/vertical-helicopter-control/docs/report-src/img/Rlocus/Esfuerzo.png

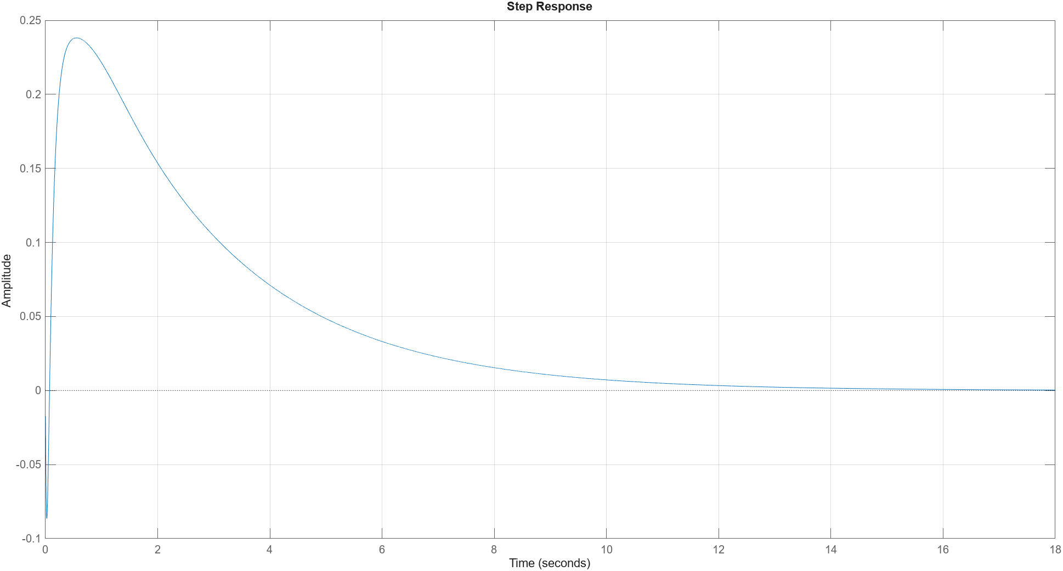
docs/report-src/img/Rlocus/Esfuerzo.png
