simplementeUnPorito/vertical-helicopter-control/docs/report-src/img/Rlocus/RlocusPractica.png

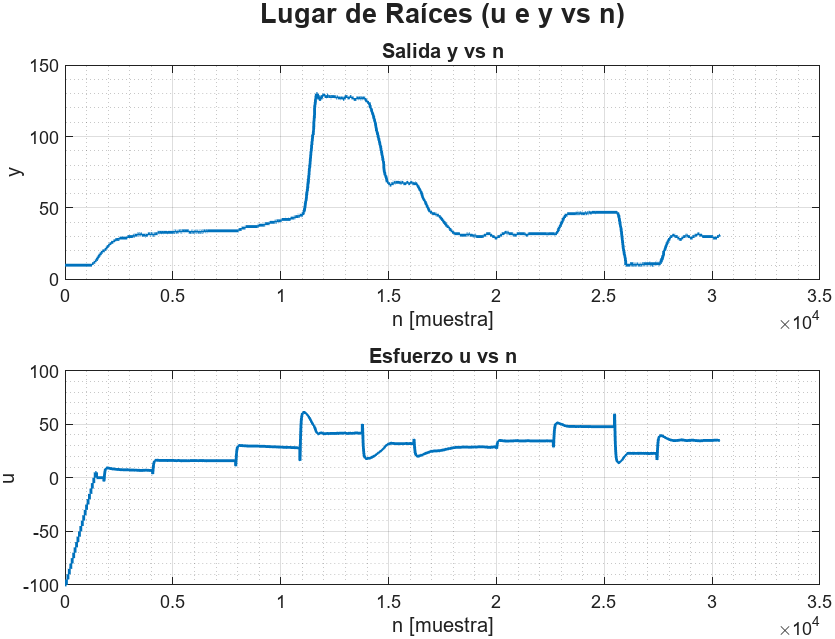
docs/report-src/img/Rlocus/RlocusPractica.png
