simplementeUnPorito/vertical-helicopter-control/docs/report-src/img/Rlocus/rsta.png

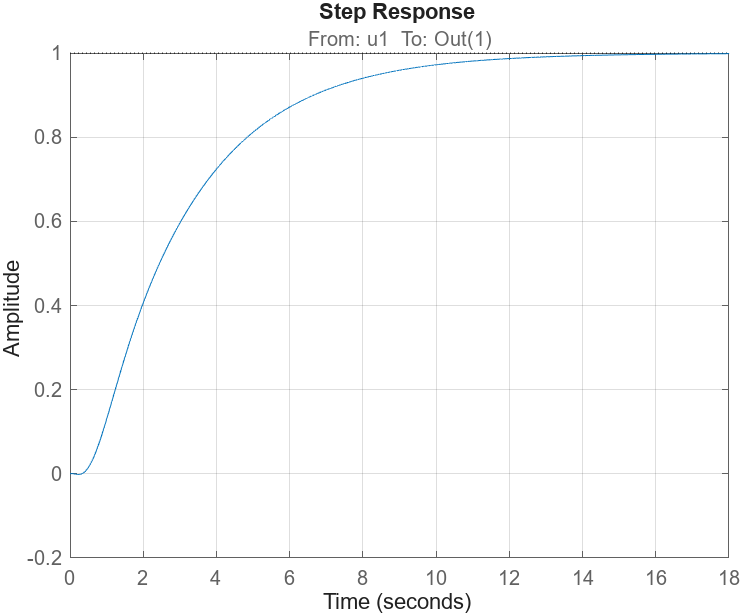
docs/report-src/img/Rlocus/rsta.png
