simplementeUnPorito/vertical-helicopter-control/docs/report-src/img/Sintesis/Bode L.png

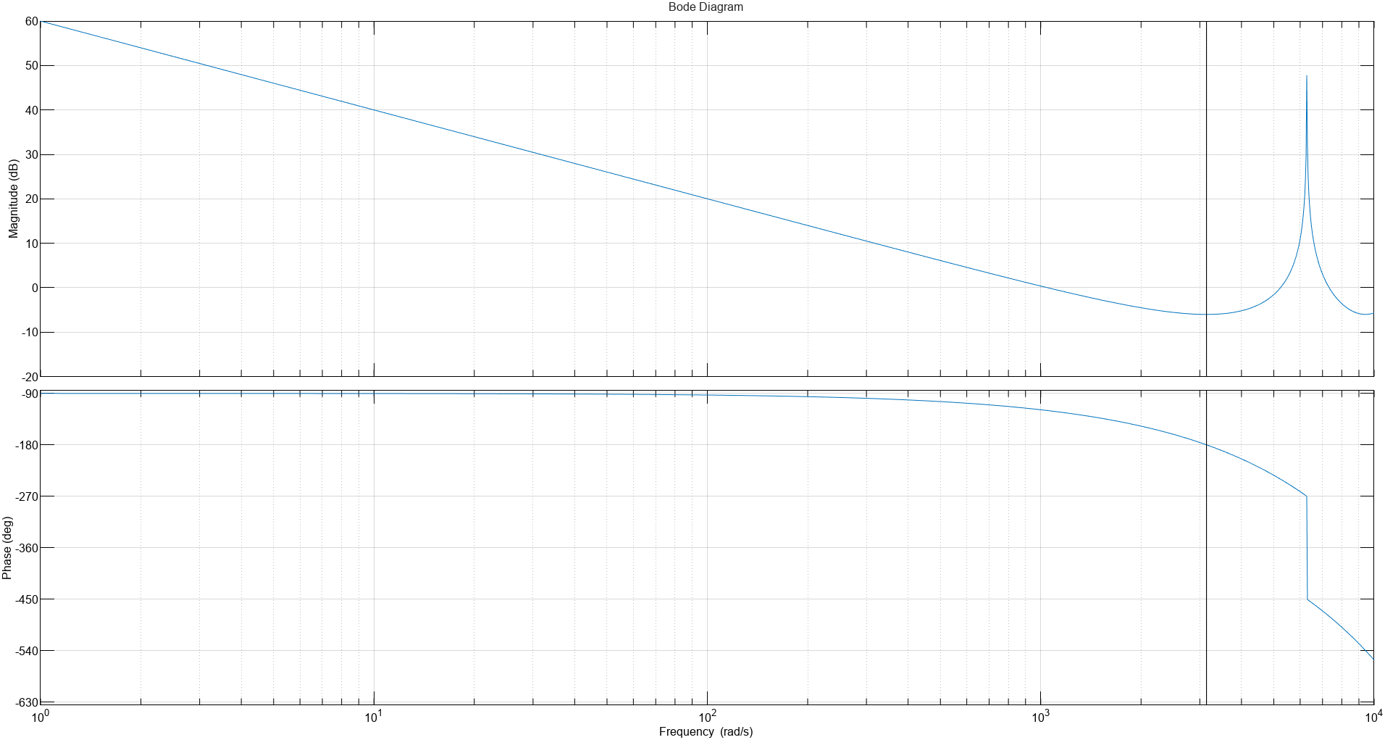
docs/report-src/img/Sintesis/Bode L.png
