simplementeUnPorito/vertical-helicopter-control/docs/report-src/img/SS/SS_actual_practico.png

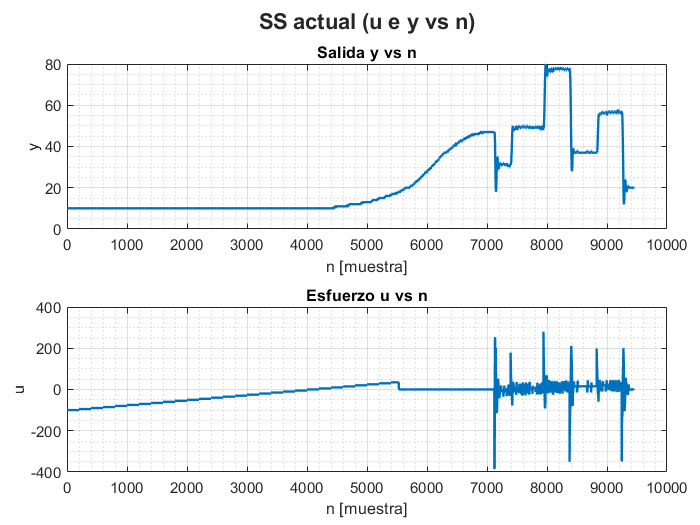
docs/report-src/img/SS/SS_actual_practico.png
