simplementeUnPorito/vertical-helicopter-control/docs/report-src/img/SS/SS_esfuerzo_noSat.png

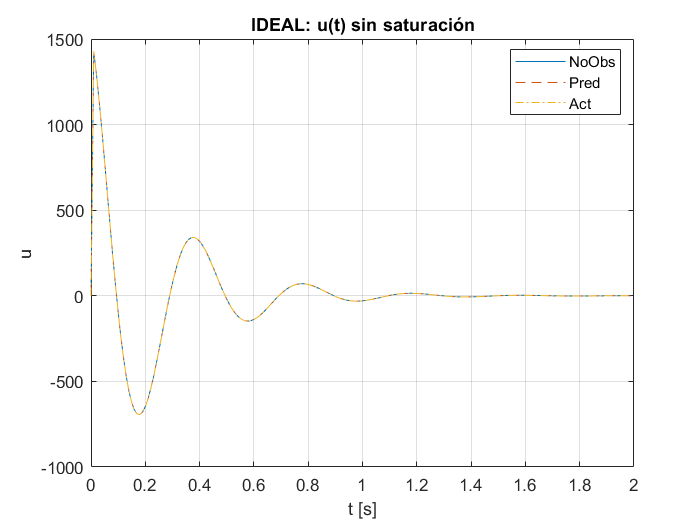
docs/report-src/img/SS/SS_esfuerzo_noSat.png
