simplementeUnPorito/vertical-helicopter-control/docs/report-src/img/SS/SS_esfuerzo_Sat.png

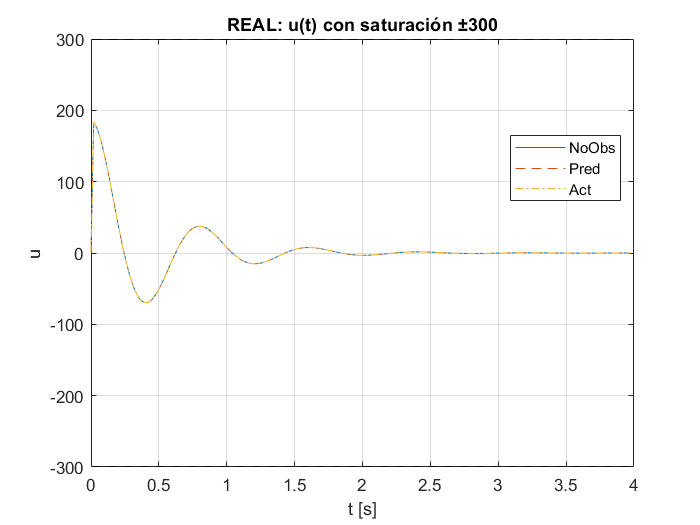
docs/report-src/img/SS/SS_esfuerzo_Sat.png
