simplementeUnPorito/vertical-helicopter-control/docs/report-src/img/SS/SS_estimador.png

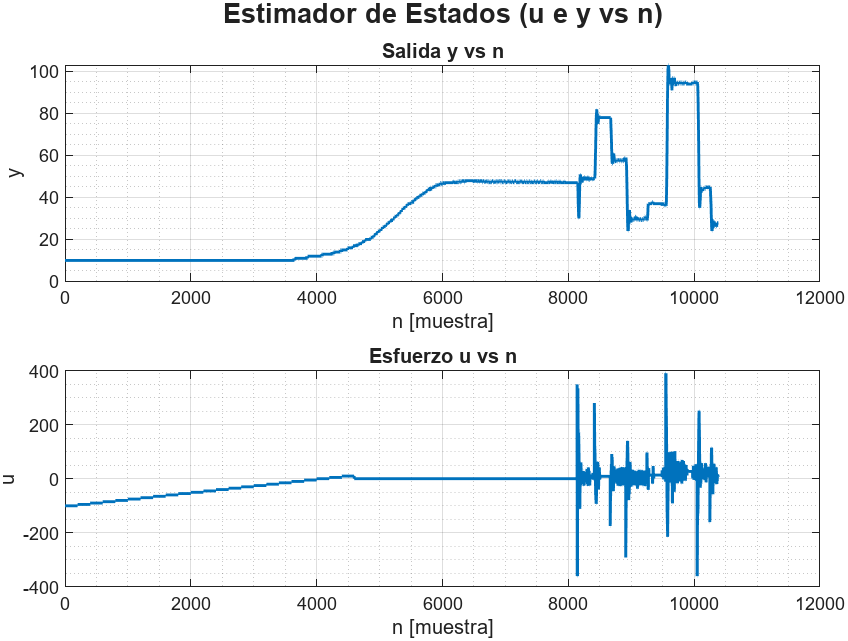
docs/report-src/img/SS/SS_estimador.png
