simplementeUnPorito/vertical-helicopter-control/docs/report-src/img/SS/SS_practico_predictor.png

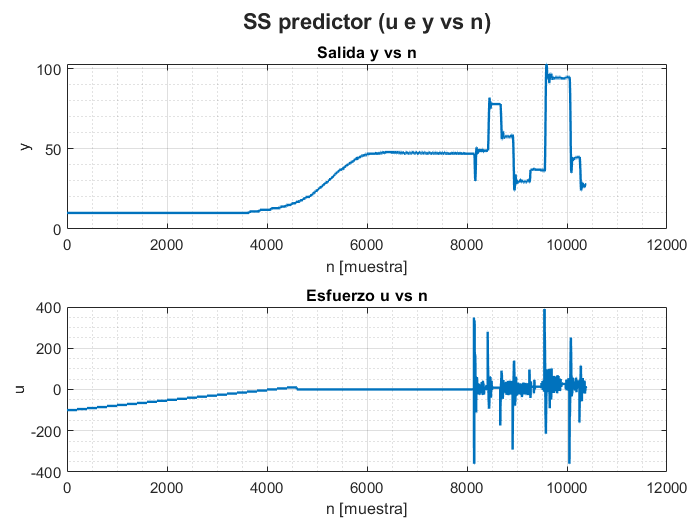
docs/report-src/img/SS/SS_practico_predictor.png
