simplementeUnPorito/vertical-helicopter-control/docs/report-src/img/SS/SS_pzmap.png

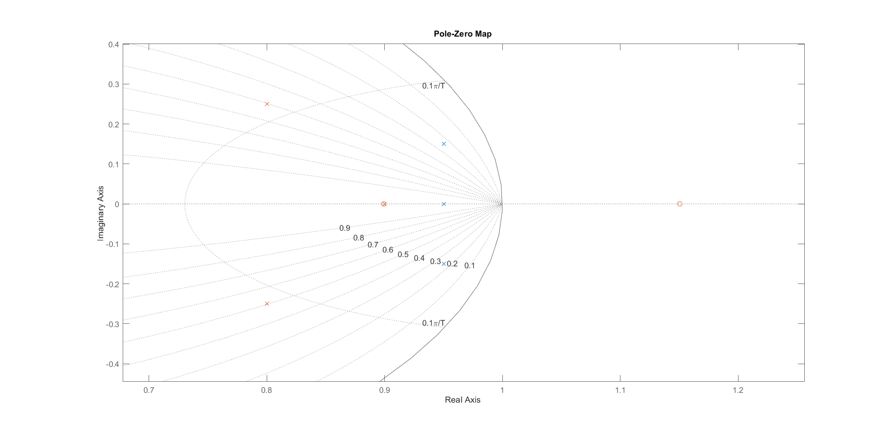
docs/report-src/img/SS/SS_pzmap.png
