simplementeUnPorito/vertical-helicopter-control/docs/report-src/img/SSi/SSi_esfuerzo.png

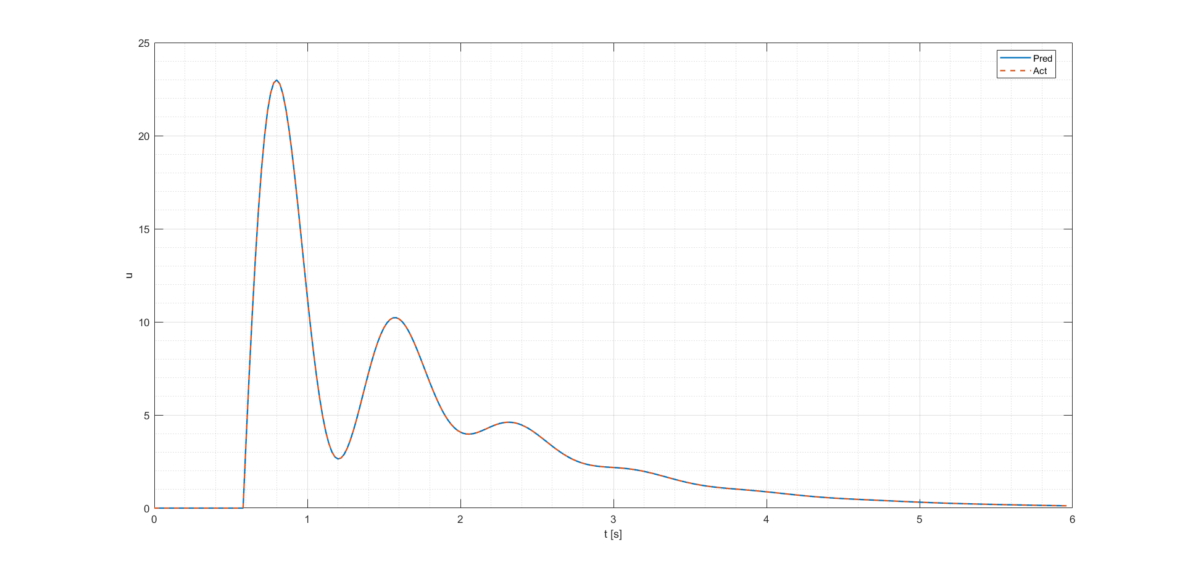
docs/report-src/img/SSi/SSi_esfuerzo.png
