simplementeUnPorito/vertical-helicopter-control/docs/report-src/img/SSi/SSi_practico_pred.png

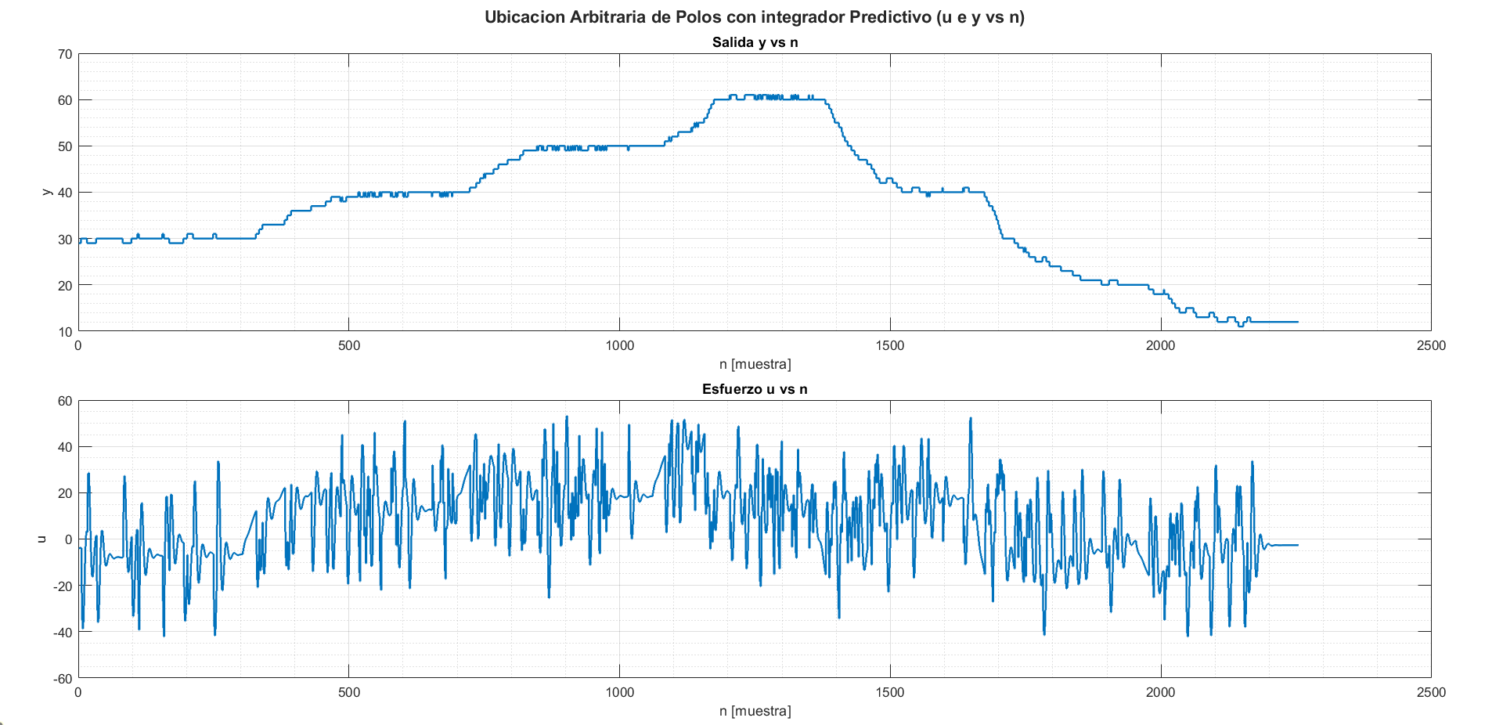
docs/report-src/img/SSi/SSi_practico_pred.png
