simplementeUnPorito/vertical-helicopter-control/docs/report-src/img/SSi/SSi_pzmap.png

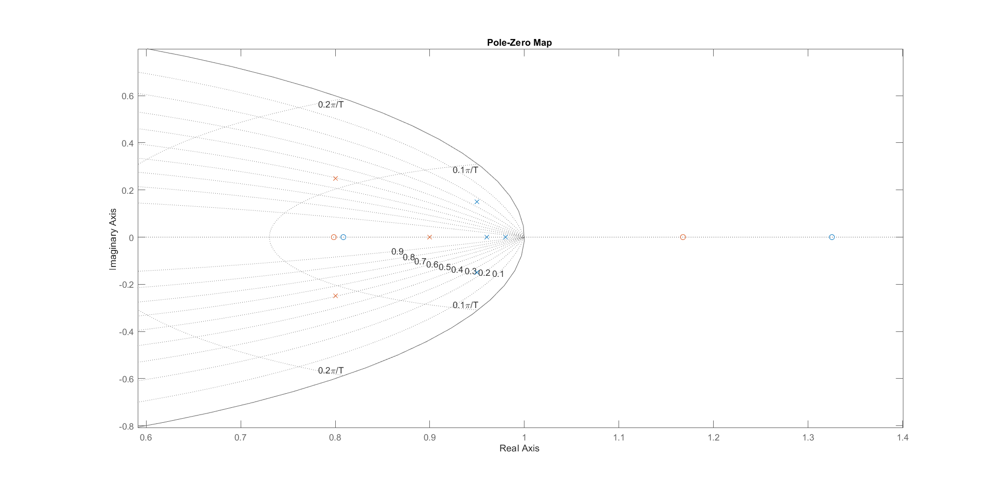
docs/report-src/img/SSi/SSi_pzmap.png
