simplementeUnPorito/vertical-helicopter-control/docs/report-src/img/Planta/materiales.png

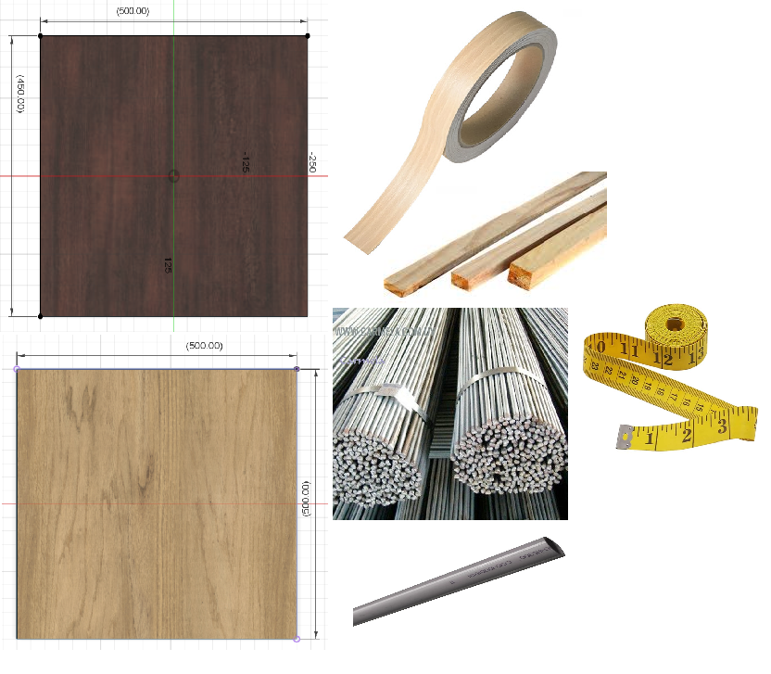
docs/report-src/img/Planta/materiales.png
