simplementeUnPorito/vertical-helicopter-control/hardware/cad/block_mgn9C_200um.3mf

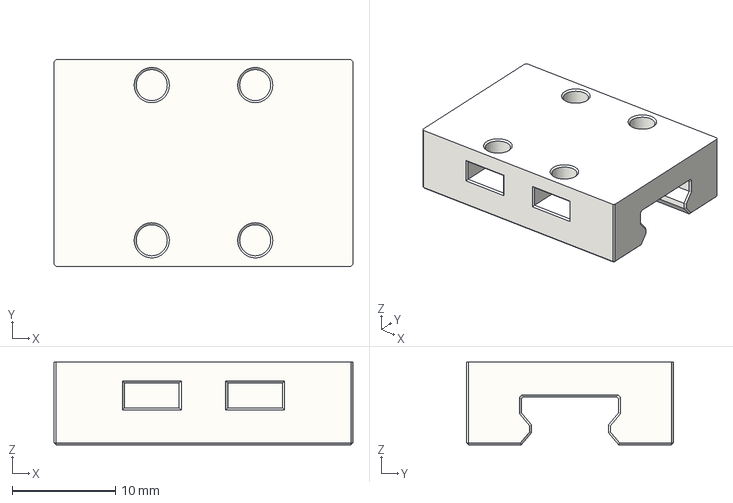
[picture p85: CAD file, 2026-11-06]
hardware/cad/block_mgn9C_200um.3mf
28.9 x 20.0 x 8.00 mm
