simplementeUnPorito/vertical-helicopter-control/hardware/cad/rail_300mm_200um_mgn9.3mf

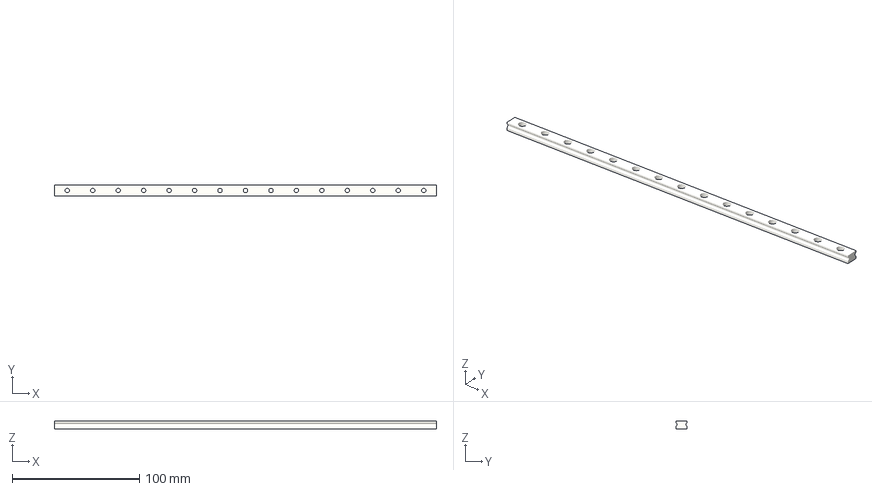
[picture p86: CAD file, 2026-11-06]
hardware/cad/rail_300mm_200um_mgn9.3mf
300.0 x 9.00 x 6.50 mm
