simplementeUnPorito/vertical-helicopter-control/(list of files, cad)

Other CAD files:
hardware/cad/Brazo3.stl
hardware/cad/Tapa.stl
hardware/cad/Tapa2.stl
hardware/cad/SoporteBateria.stl
hardware/cad/Pivote.stl
hardware/cad/Brazo1.stl
hardware/cad/Brazo2.stl
