simplementeUnPorito/vertical-helicopter-control/docs/report-src/img/LQGi/LQGi_step_ruido.png

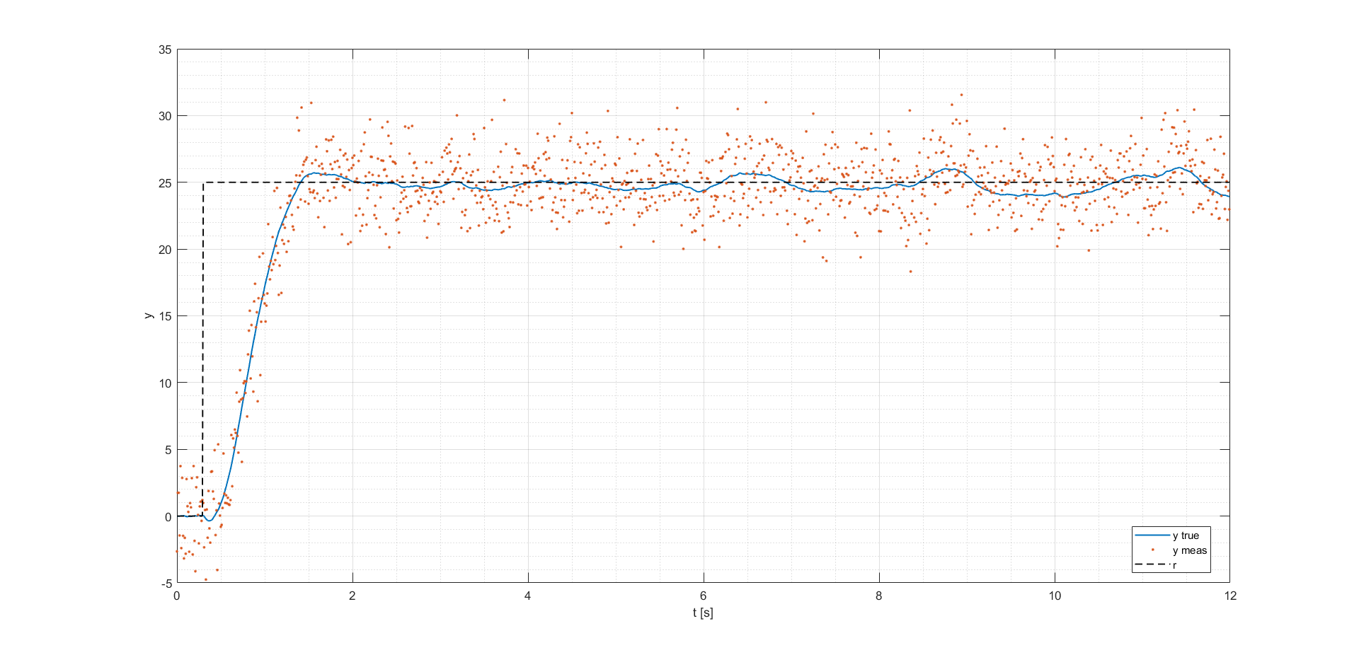
docs/report-src/img/LQGi/LQGi_step_ruido.png
