simplementeUnPorito/vertical-helicopter-control/docs/report-src/img/LQR/LQR_step.png

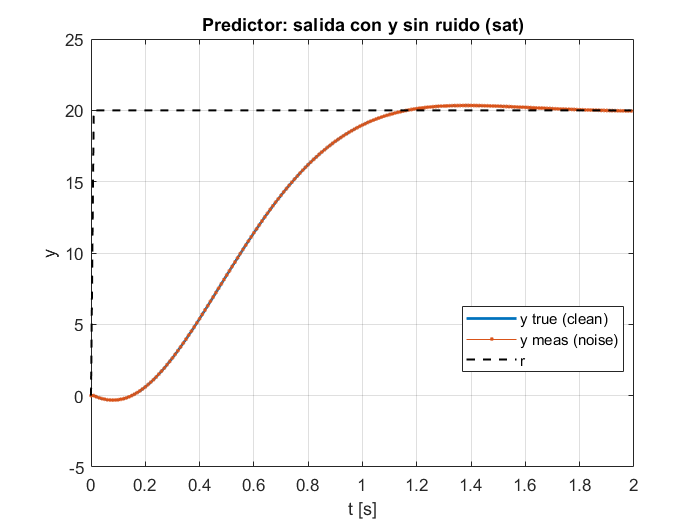
docs/report-src/img/LQR/LQR_step.png
