simplementeUnPorito/vertical-helicopter-control/docs/report-src/img/Sintesis/Step_esfuerzoConOscilaciones.png

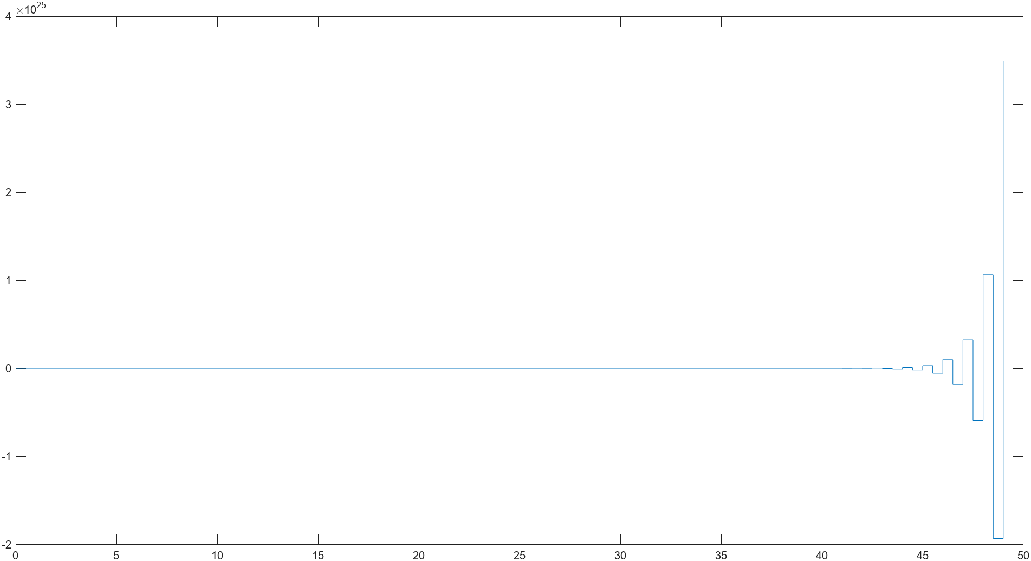
docs/report-src/img/Sintesis/Step_esfuerzoConOscilaciones.png
