simplementeUnPorito/vertical-helicopter-control/docs/report-src/img/Sintesis/Step_esfuerzoSinOscilaciones.png

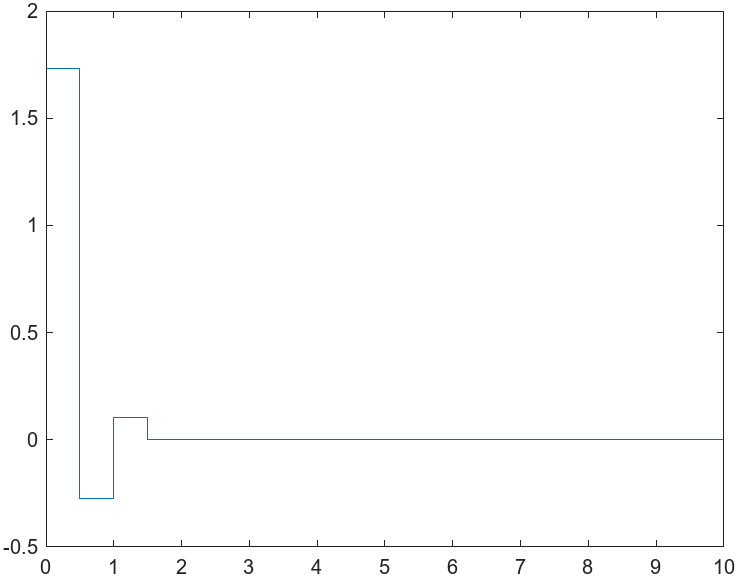
docs/report-src/img/Sintesis/Step_esfuerzoSinOscilaciones.png
