simplementeUnPorito/vertical-helicopter-control/docs/report-src/img/Sintesis/Step_salidaConOscilaciones.png

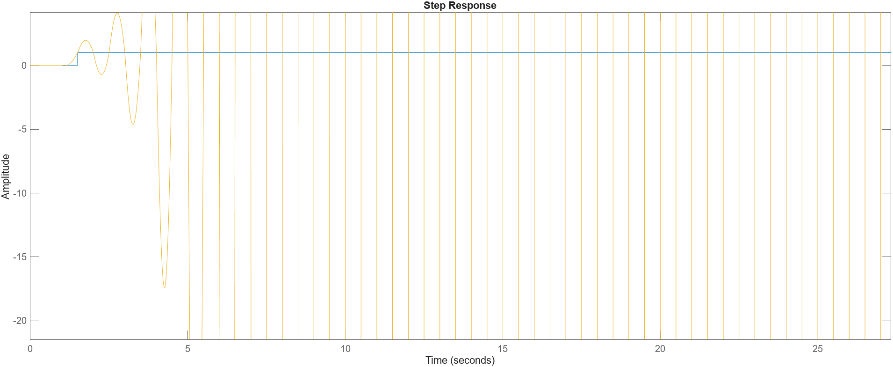
docs/report-src/img/Sintesis/Step_salidaConOscilaciones.png
