simplementeUnPorito/vertical-helicopter-control/docs/report-src/img/Sintesis/Step_salidaSinOscilaciones.png

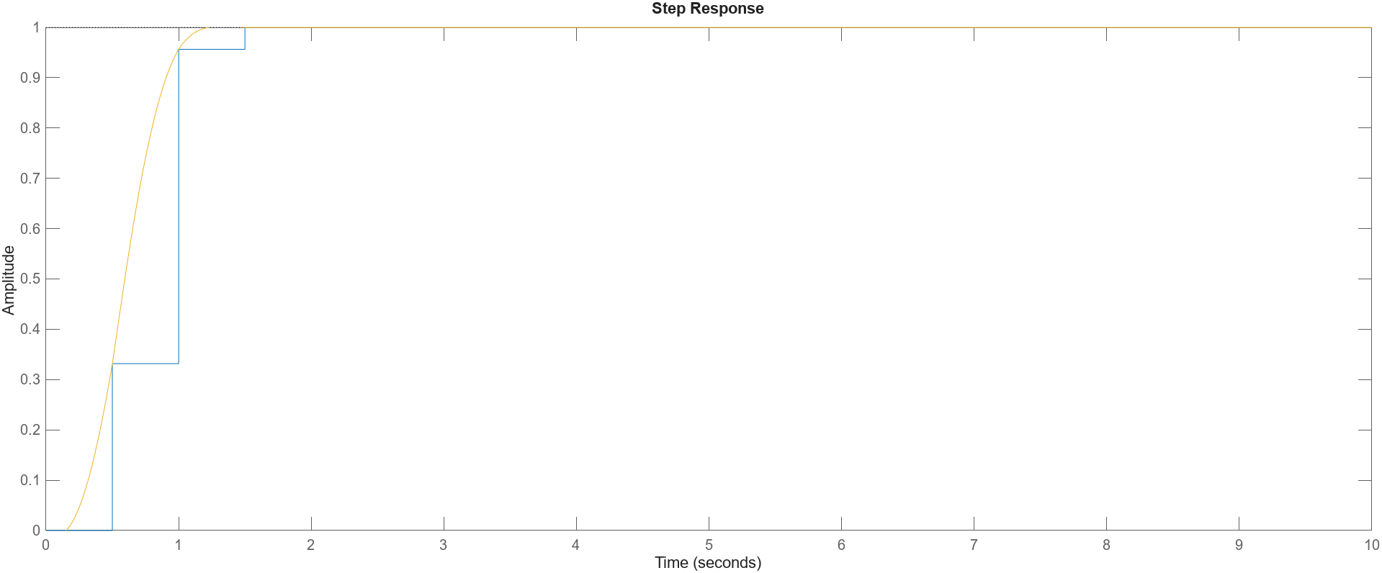
docs/report-src/img/Sintesis/Step_salidaSinOscilaciones.png
