simplementeUnPorito/vertical-helicopter-control/docs/report-src/img/SS/SS_step_noSat.png

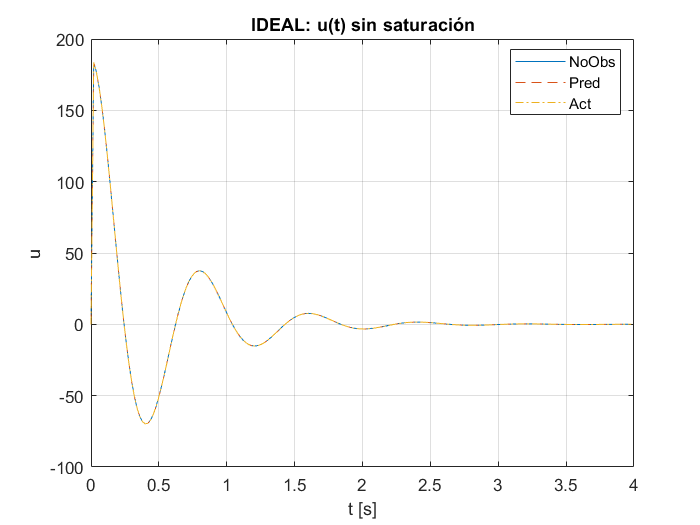
docs/report-src/img/SS/SS_step_noSat.png
