simplementeUnPorito/vertical-helicopter-control/docs/report-src/img/SS/SS_step_Sat.png

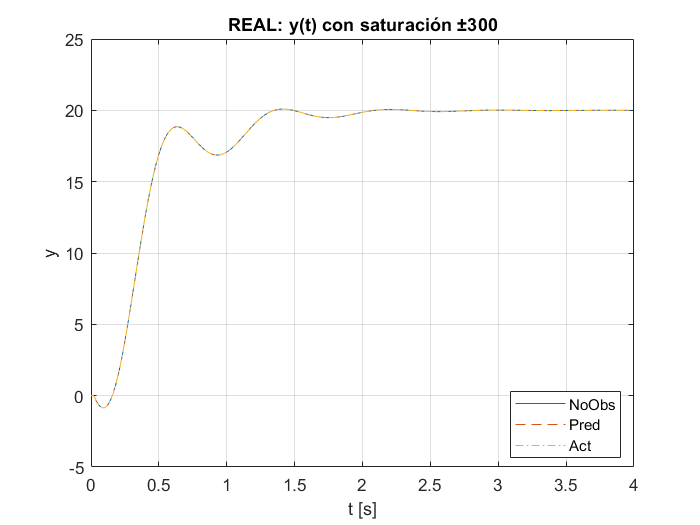
docs/report-src/img/SS/SS_step_Sat.png
