simplementeUnPorito/vertical-helicopter-control/docs/report-src/img/SSi/SSi_step.png

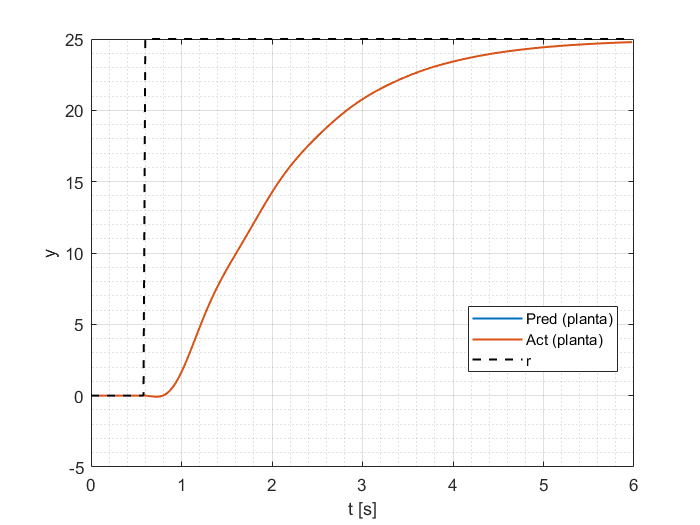
docs/report-src/img/SSi/SSi_step.png
