simplementeUnPorito/vertical-helicopter-control/docs/report-src/img/SS/SS_todoJunto.png

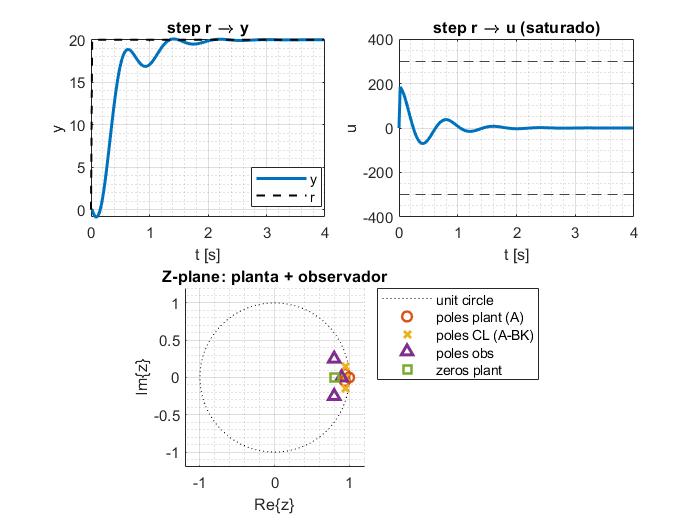
docs/report-src/img/SS/SS_todoJunto.png
