simplementeUnPorito/vertical-helicopter-control/(commit log)

2026-11-06 Initial public release
    [Brazo1.stl, Brazo2.stl, Brazo3.stl, Pivote.stl, SoporteBateria.stl, Tapa.stl, Tapa2.stl, block_mgn9C_200um.3mf]
2026-11-07 Add prototype and bench photo galleries
